woolimi/pinkrab/docs/src/content/docs/index.mdx

---
title: Pinkrab
description: 벽에 부착하는 6-DOF 양팔 로봇과 UMI 그리퍼 Hermit.
template: splash
---

import Landing from '../../components/Landing.astro';

<Landing />
