woolimi/pinkrab/docs/src/content/docs/en/index.mdx

---
title: Pinkrab
description: A wall-mounted 6-DOF bimanual robot and Hermit, a UMI gripper.
template: splash
---

import Landing from '../../../components/Landing.astro';

<Landing />
