woolimi/pinkrab/src/pinkrab_description/meshes/base_right.stl

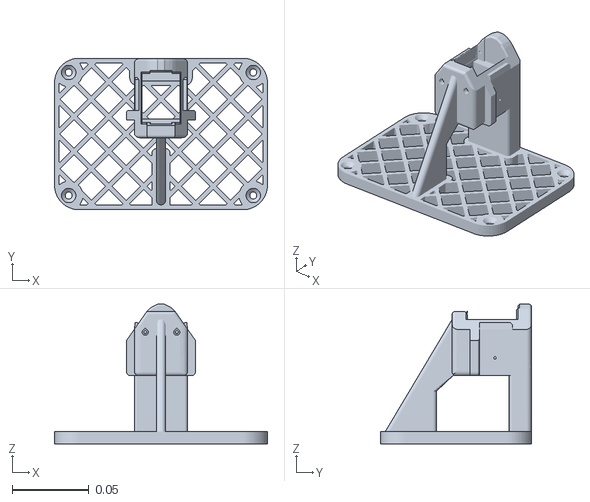
[picture p11: CAD file, 2026-11-01]
src/pinkrab_description/meshes/base_right.stl
0.139 x 0.0985 x 0.0908
