woolimi/pinkrab/src/pinkrab_description/mjcf/collision/camera_bracket_right_c05.stl

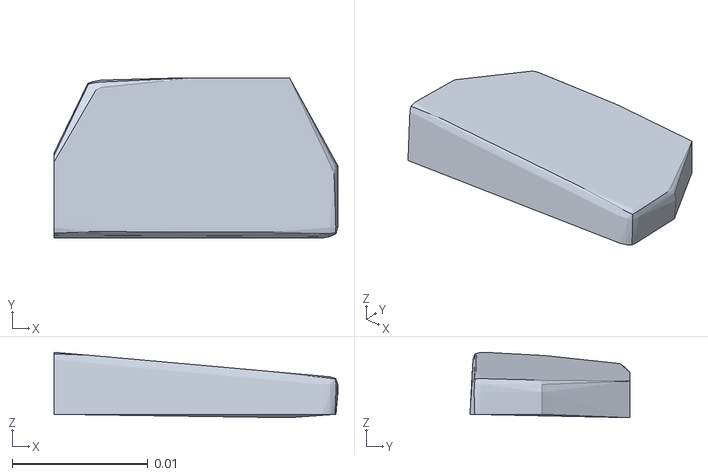
[picture p12: CAD file, 2026-11-01]
src/pinkrab_description/mjcf/collision/camera_bracket_right_c05.stl
0.0209 x 0.0118 x 0.00482
