woolimi/pinkrab/src/pinkrab_description/print/shoulder_right.stl

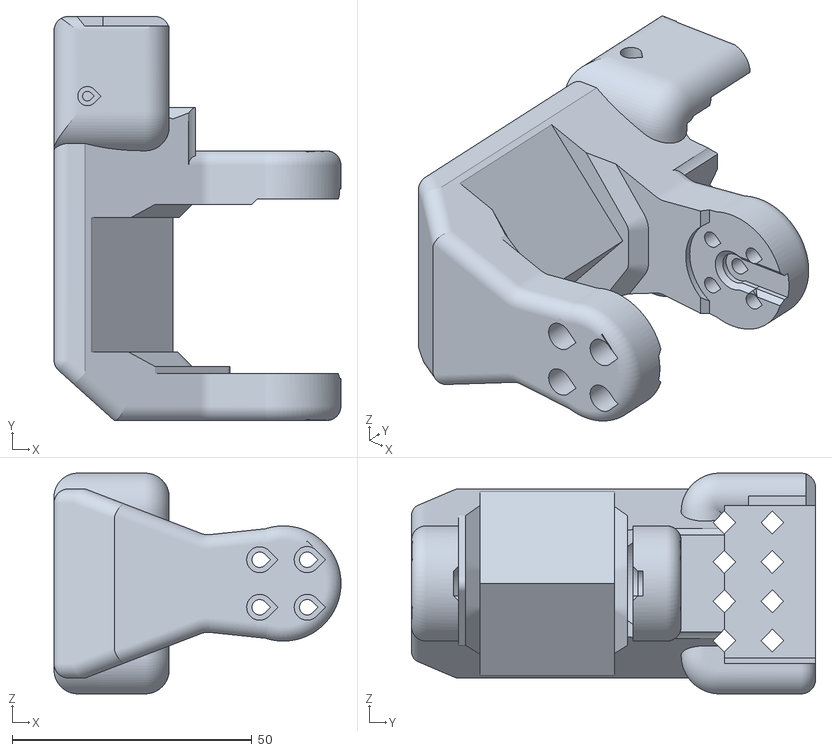
[picture p13: CAD file, 2026-11-01]
src/pinkrab_description/print/shoulder_right.stl
59.8 x 84.2 x 46.0
