woolimi/pinkrab/src/pinkrab_umi/meshes/handheld_peg_right.stl

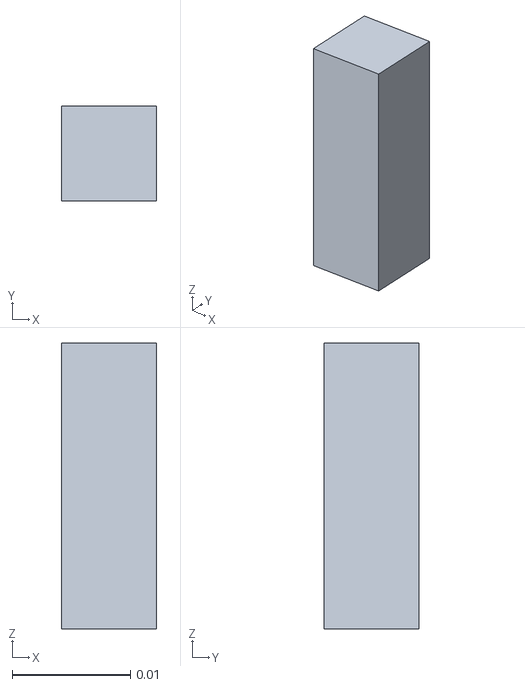
[picture p14: CAD file, 2026-11-01]
src/pinkrab_umi/meshes/handheld_peg_right.stl
0.008 x 0.008 x 0.0242
