woolimi/pinkrab/src/pinkrab_umi/print/marker_solid_tiles_desk.stl

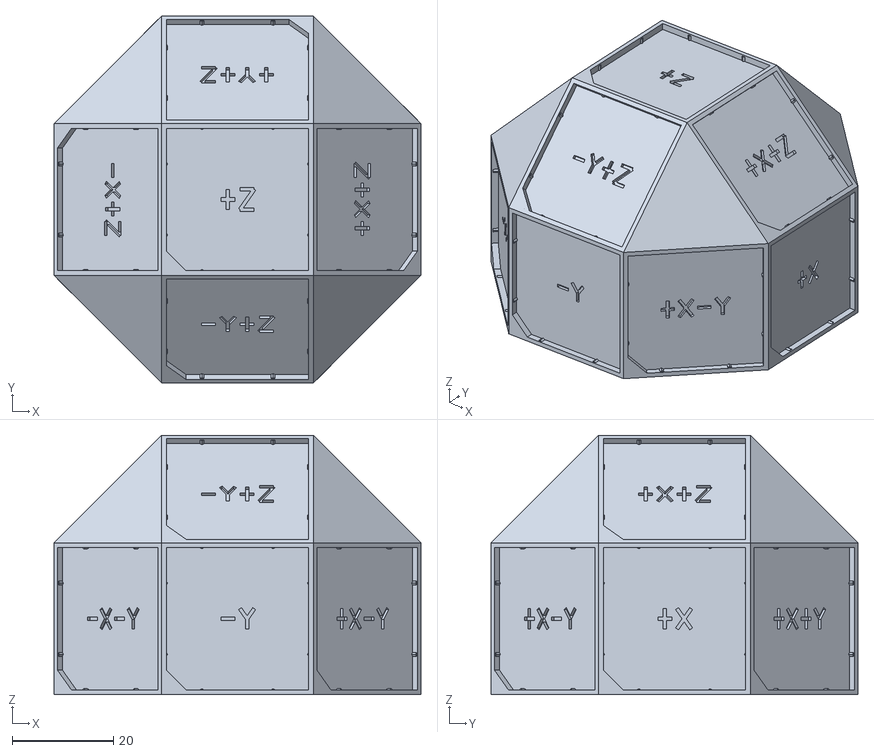
[picture p15: CAD file, 2026-11-01]
src/pinkrab_umi/print/marker_solid_tiles_desk.stl
72.4 x 72.4 x 51.2
