woolimi/pinkrab/src/pinkrab_description/meshes/wrist_left.stl

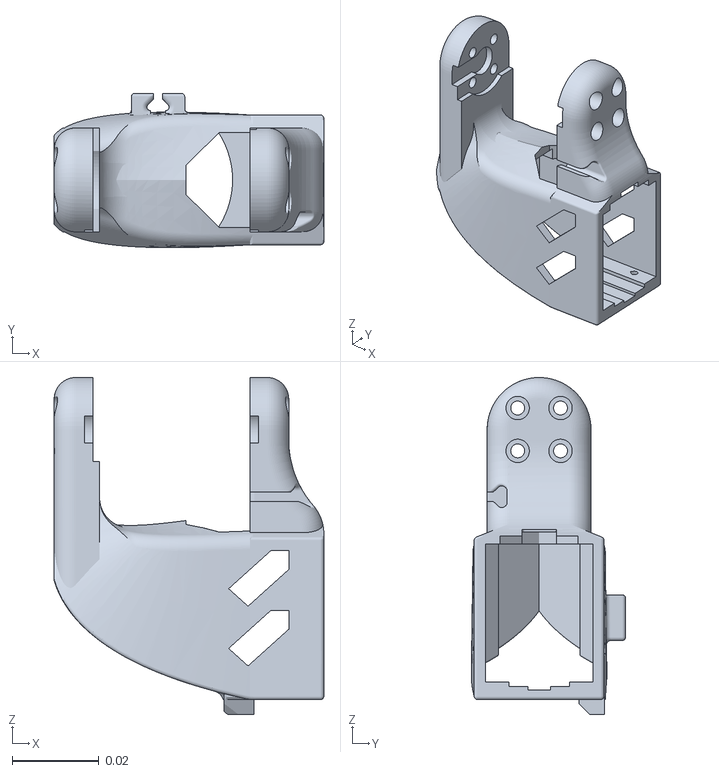
[picture p16: CAD file, 2026-11-01]
src/pinkrab_description/meshes/wrist_left.stl
0.0623 x 0.0357 x 0.0778
