woolimi/pinkrab/src/pinkrab_description/mjcf/collision/jaw_right_c05.stl

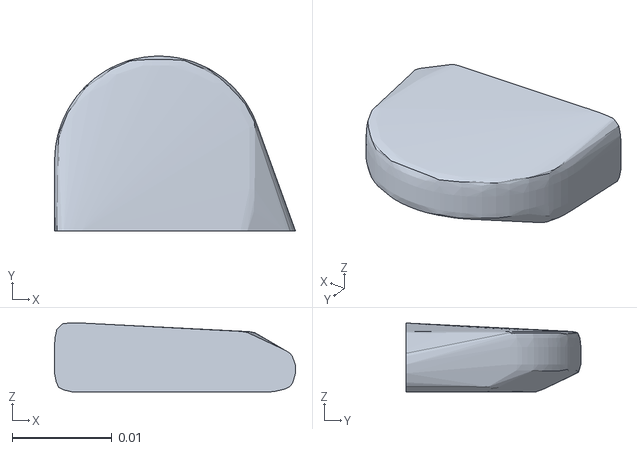
[picture p17: CAD file, 2026-11-01]
src/pinkrab_description/mjcf/collision/jaw_right_c05.stl
0.0242 x 0.0175 x 0.00692
