woolimi/pinkrab/src/pinkrab_description/print/driver_mount_left.stl

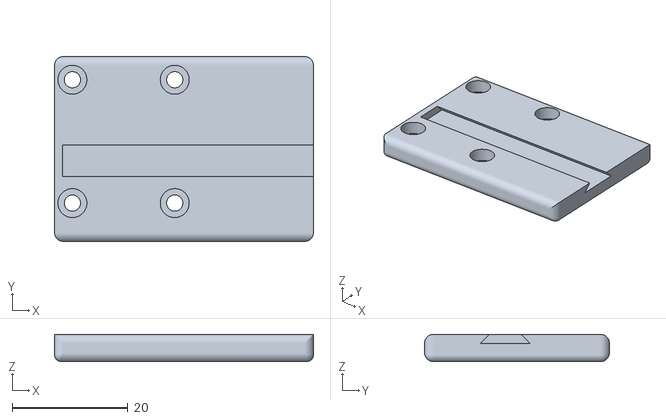
[picture p18: CAD file, 2026-11-01]
src/pinkrab_description/print/driver_mount_left.stl
44.7 x 31.9 x 4.68
