woolimi/pinkrab/src/pinkrab_umi/meshes/camera_bracket_right.stl

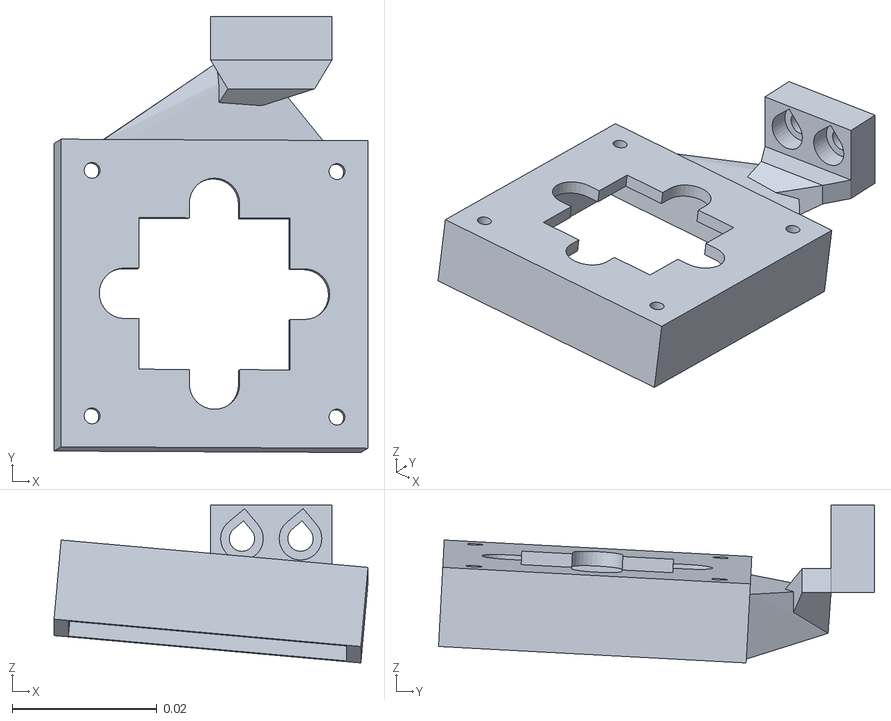
[picture p19: CAD file, 2026-11-01]
src/pinkrab_umi/meshes/camera_bracket_right.stl
0.0434 x 0.0603 x 0.0218
