woolimi/pinkrab/src/pinkrab_umi/print/camera_bracket_left.stl

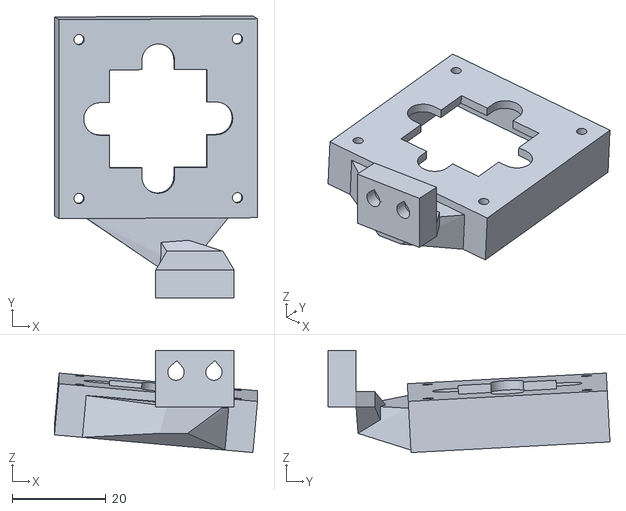
[picture p20: CAD file, 2026-11-01]
src/pinkrab_umi/print/camera_bracket_left.stl
43.4 x 60.3 x 21.8
