woolimi/pinkrab/src/pinkrab_description/mjcf/collision/claw_right_c08.stl

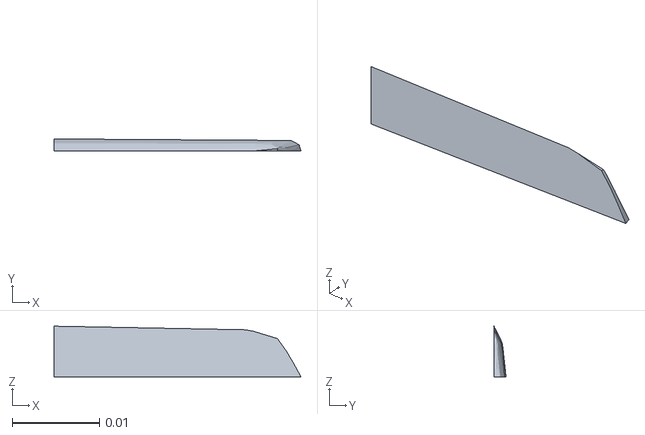
[picture p21: CAD file, 2026-11-01]
src/pinkrab_description/mjcf/collision/claw_right_c08.stl
0.0284 x 0.0014 x 0.00582
