woolimi/pinkrab/src/pinkrab_umi/meshes/board_mount_right.stl

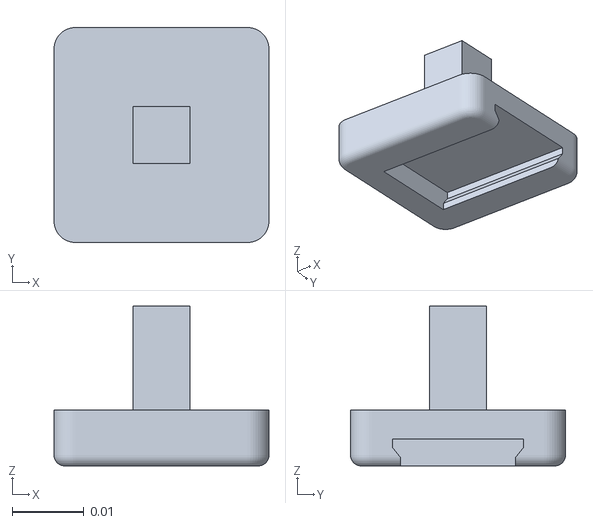
[picture p22: CAD file, 2026-11-01]
src/pinkrab_umi/meshes/board_mount_right.stl
0.03 x 0.03 x 0.0223
