woolimi/pinkrab/src/pinkrab_umi/print/handheld_jaw_right.stl

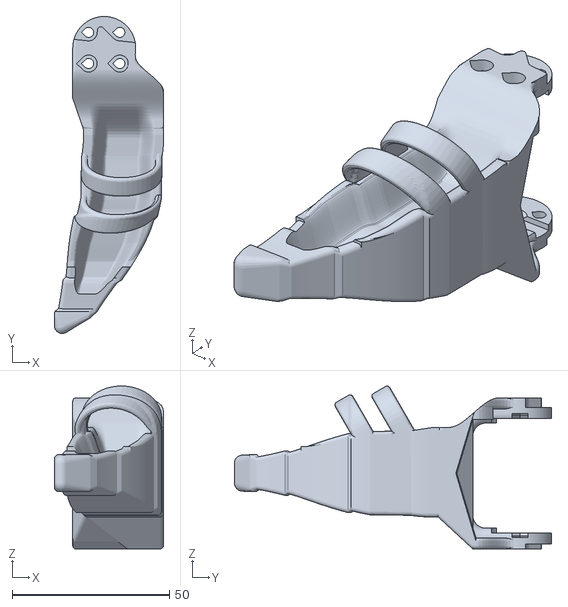
[picture p23: CAD file, 2026-11-01]
src/pinkrab_umi/print/handheld_jaw_right.stl
34.8 x 100.7 x 51.8
