woolimi/pinkrab/src/pinkrab_description/meshes/jaw_right.stl

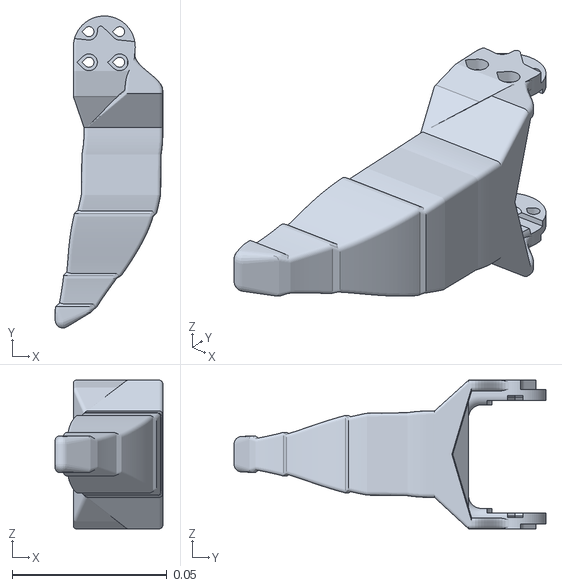
[picture p24: CAD file, 2026-11-01]
src/pinkrab_description/meshes/jaw_right.stl
0.0348 x 0.101 x 0.048
