woolimi/pinkrab/src/pinkrab_description/mjcf/collision/camera_bracket_right_c20.stl

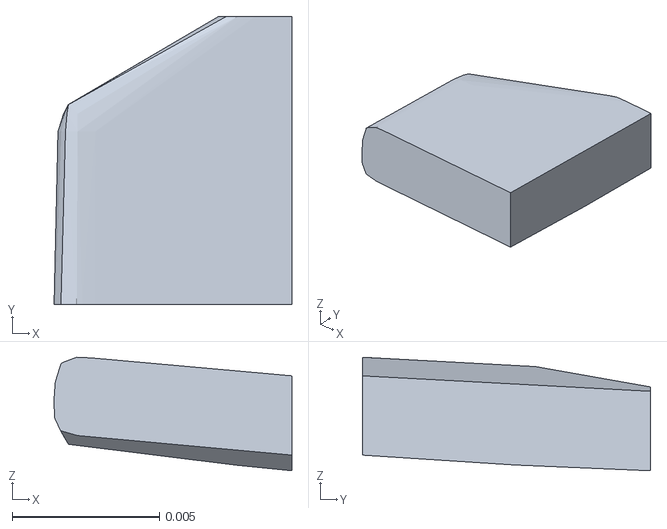
[picture p25: CAD file, 2026-11-01]
src/pinkrab_description/mjcf/collision/camera_bracket_right_c20.stl
0.00807 x 0.00977 x 0.00385
