woolimi/pinkrab/src/pinkrab_umi/meshes/marker_solid_handheld_left.stl

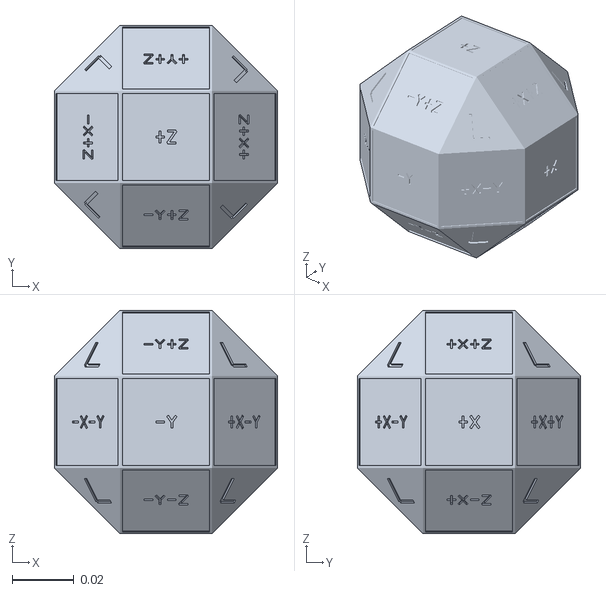
[picture p26: CAD file, 2026-11-01]
src/pinkrab_umi/meshes/marker_solid_handheld_left.stl
0.0724 x 0.0724 x 0.0724
