woolimi/pinkrab/src/pinkrab_description/mjcf/collision/claw_left_c04.stl

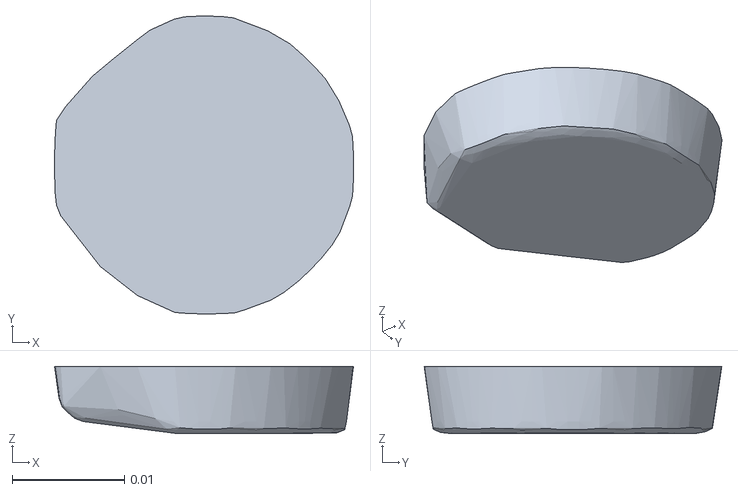
[picture p27: CAD file, 2026-11-01]
src/pinkrab_description/mjcf/collision/claw_left_c04.stl
0.0267 x 0.0266 x 0.00602
