woolimi/pinkrab/src/pinkrab_description/print/base_servo_mount_left.stl

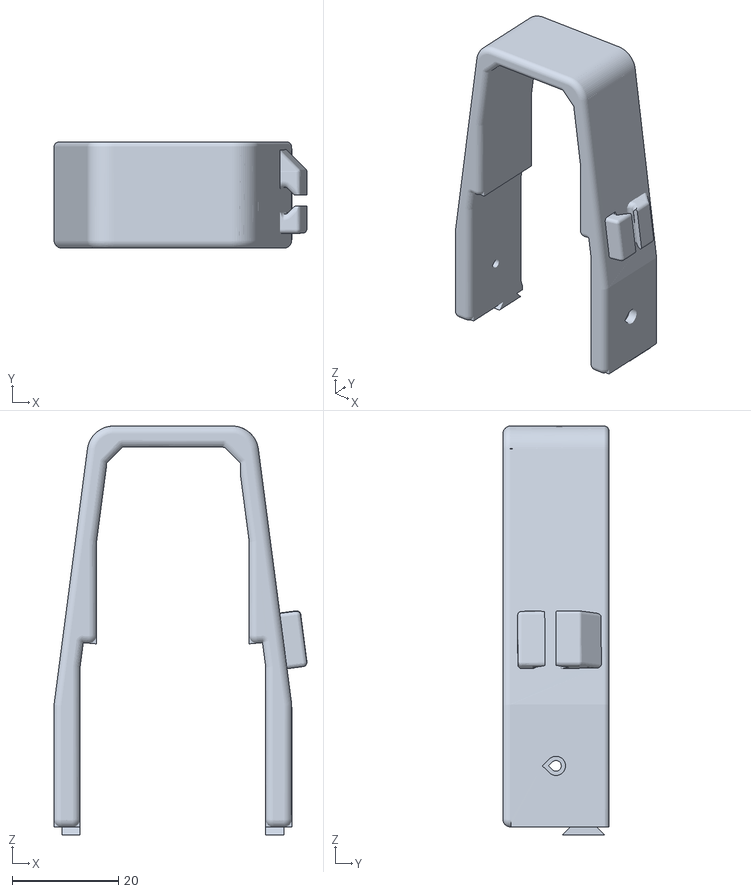
[picture p28: CAD file, 2026-11-01]
src/pinkrab_description/print/base_servo_mount_left.stl
47.6 x 20.0 x 76.9
