woolimi/pinkrab/src/pinkrab_umi/meshes/handheld_body_right.stl

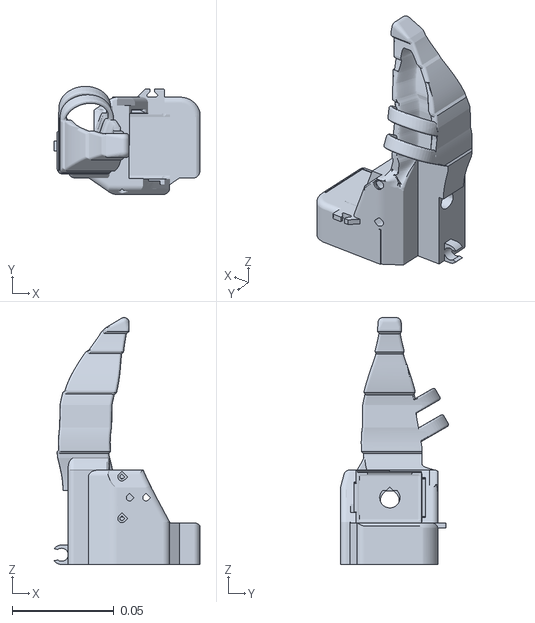
[picture p29: CAD file, 2026-11-01]
src/pinkrab_umi/meshes/handheld_body_right.stl
0.0718 x 0.0533 x 0.122
