woolimi/pinkrab/src/pinkrab_umi/print/driver_plate_left.stl

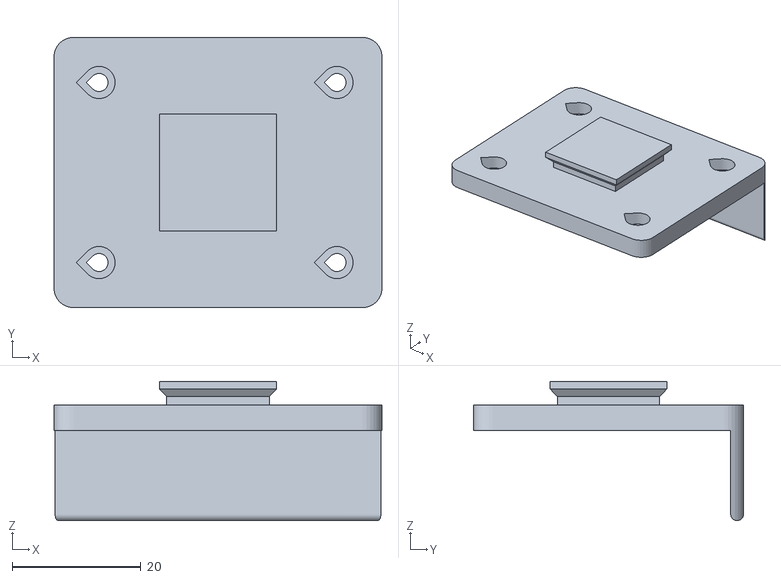
[picture p30: CAD file, 2026-11-01]
src/pinkrab_umi/print/driver_plate_left.stl
51.0 x 42.0 x 21.6
