woolimi/pinkrab/src/pinkrab_description/meshes/upper_arm_right.stl

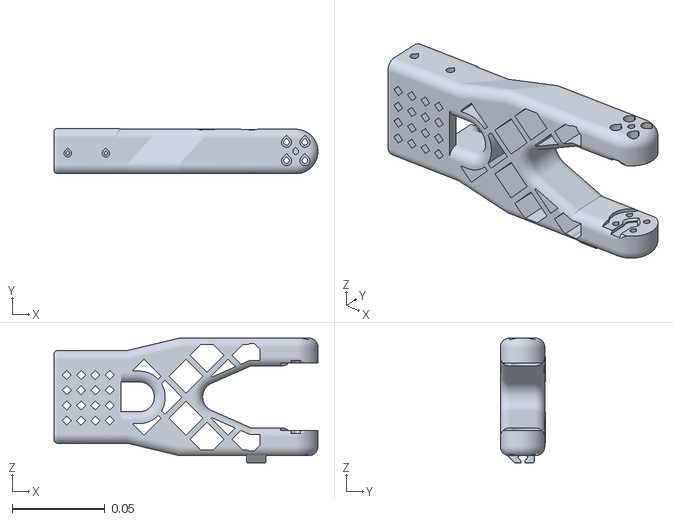
[picture p31: CAD file, 2026-11-01]
src/pinkrab_description/meshes/upper_arm_right.stl
0.142 x 0.0245 x 0.0673
