woolimi/pinkrab/src/pinkrab_description/mjcf/collision/camera_bracket_right_c18.stl

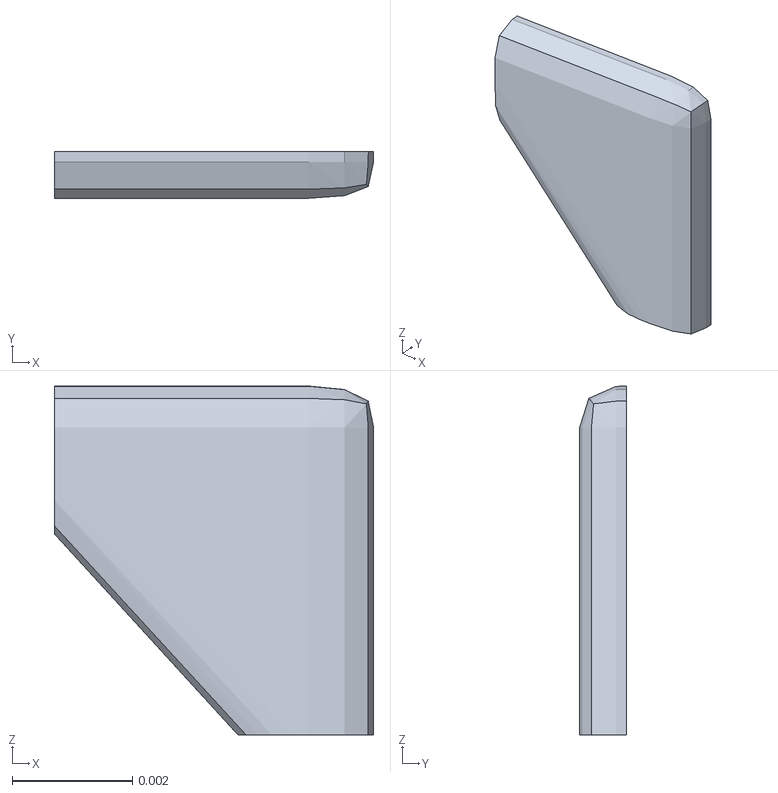
[picture p32: CAD file, 2026-11-01]
src/pinkrab_description/mjcf/collision/camera_bracket_right_c18.stl
0.0053 x 0.000774 x 0.0058
