woolimi/pinkrab/src/pinkrab_umi/meshes/driver_plate_left.stl

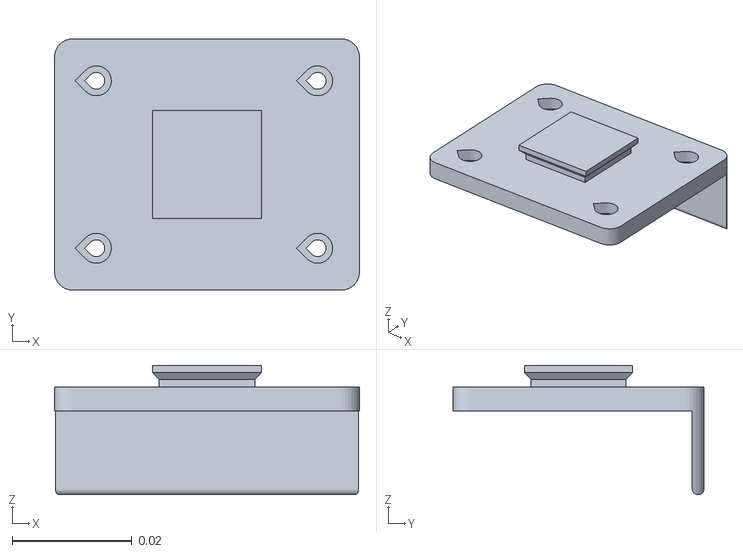
[picture p33: CAD file, 2026-11-01]
src/pinkrab_umi/meshes/driver_plate_left.stl
0.051 x 0.042 x 0.0216
