woolimi/pinkrab/src/pinkrab_description/mjcf/collision/camera_bracket_left_c14.stl

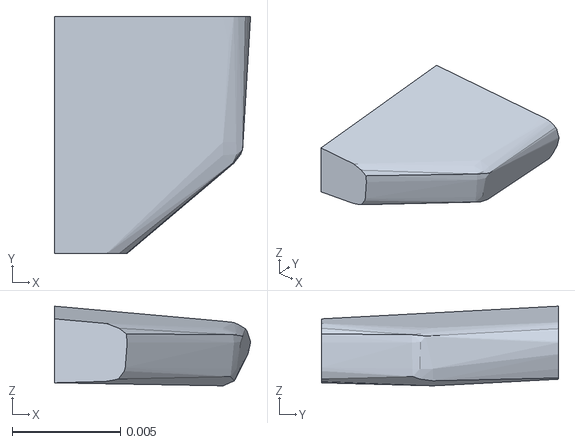
[picture p35: CAD file, 2026-11-01]
src/pinkrab_description/mjcf/collision/camera_bracket_left_c14.stl
0.00906 x 0.0109 x 0.00368
