woolimi/pinkrab/src/pinkrab_description/print/shoulder_servo_mount_right.stl

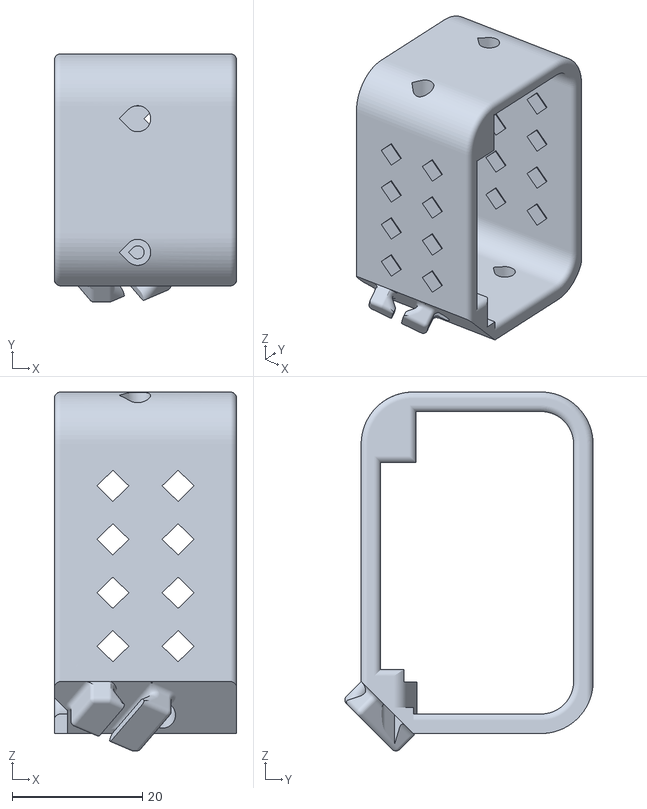
[picture p36: CAD file, 2026-11-01]
src/pinkrab_description/print/shoulder_servo_mount_right.stl
28.0 x 38.1 x 55.1
