woolimi/pinkrab/src/pinkrab_umi/print/board_mount_right.stl

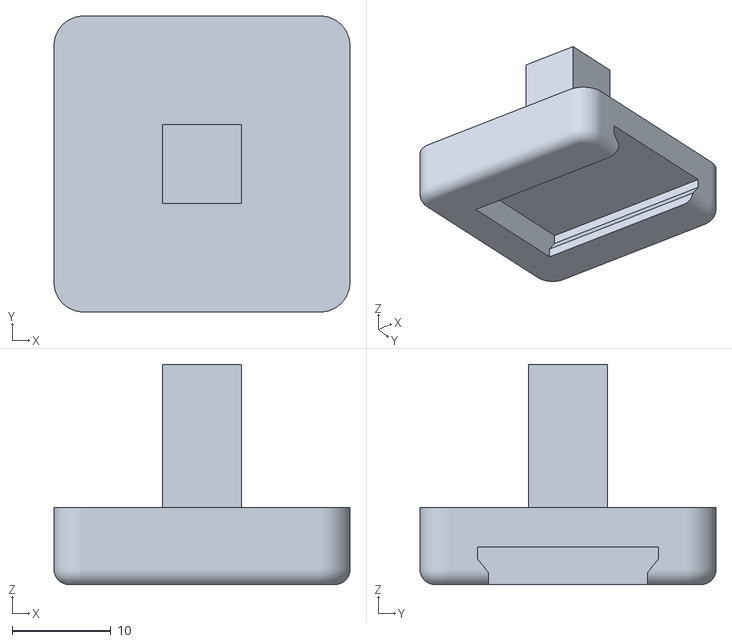
[picture p37: CAD file, 2026-11-01]
src/pinkrab_umi/print/board_mount_right.stl
30.0 x 30.0 x 22.3
