woolimi/pinkrab/src/pinkrab_description/mjcf/collision/camera_bracket_left_c17.stl

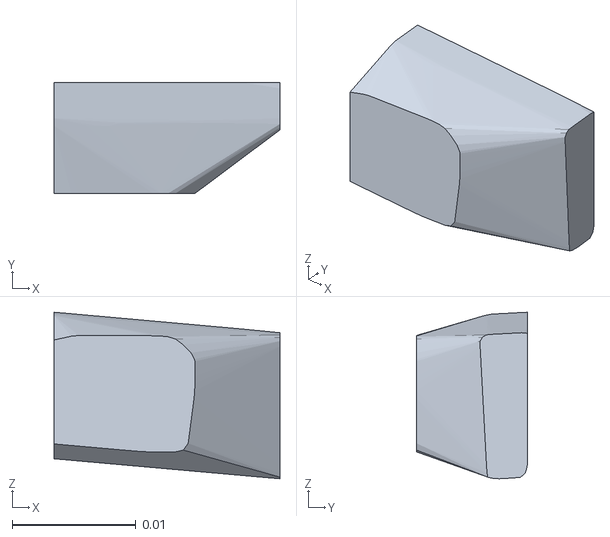
[picture p38: CAD file, 2026-11-01]
src/pinkrab_description/mjcf/collision/camera_bracket_left_c17.stl
0.0183 x 0.00897 x 0.0135
