woolimi/pinkrab/src/pinkrab_description/print/driver_mount_right.stl

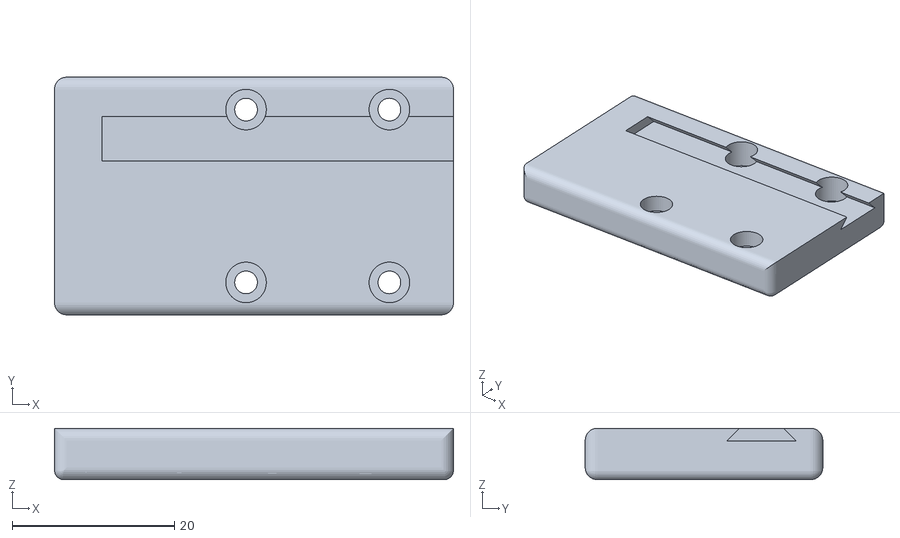
[picture p39: CAD file, 2026-11-01]
src/pinkrab_description/print/driver_mount_right.stl
49.2 x 29.3 x 6.33
