woolimi/pinkrab/src/pinkrab_umi/meshes/handheld_jaw_right.stl

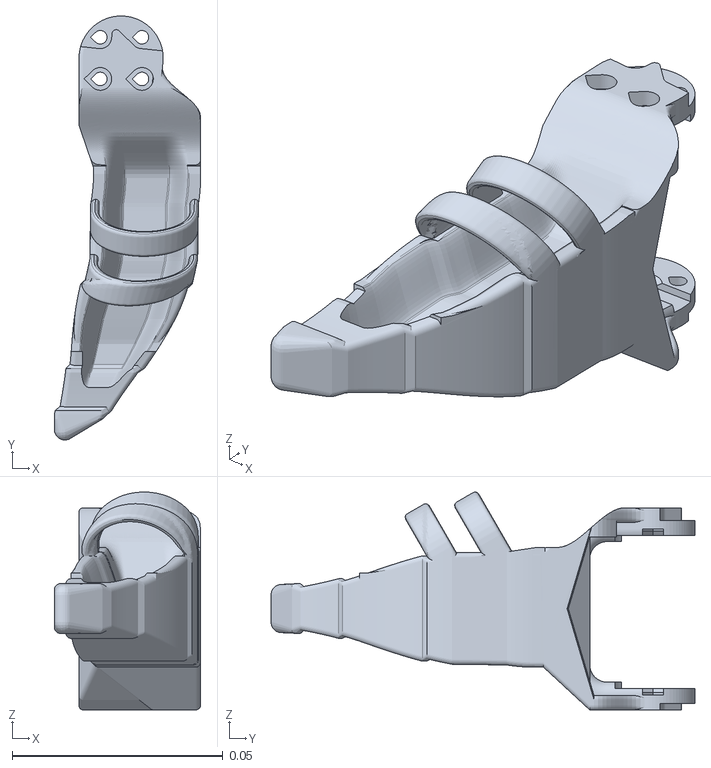
[picture p40: CAD file, 2026-11-01]
src/pinkrab_umi/meshes/handheld_jaw_right.stl
0.0348 x 0.101 x 0.0518
