woolimi/pinkrab/src/pinkrab_umi/print/marker_solid_handheld_left.stl

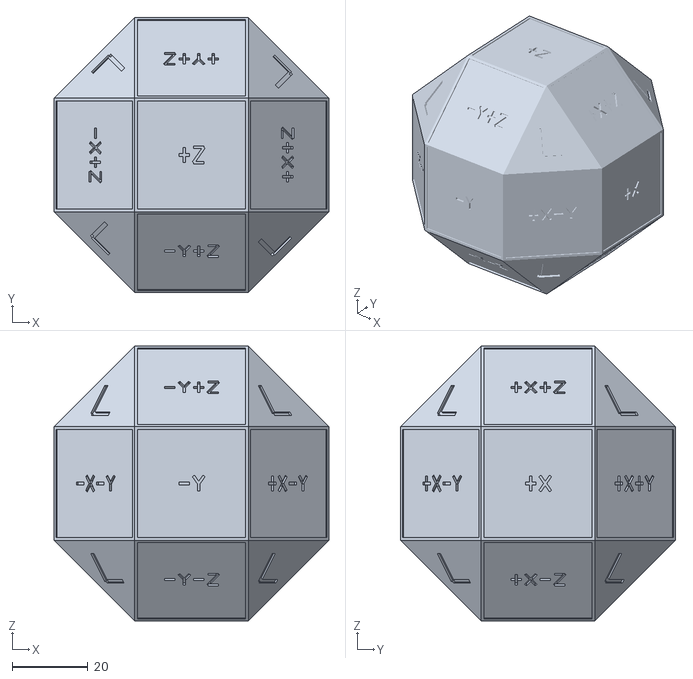
[picture p41: CAD file, 2026-11-01]
src/pinkrab_umi/print/marker_solid_handheld_left.stl
72.4 x 72.4 x 72.4
