woolimi/pinkrab/src/pinkrab_description/meshes/driver_mount_right.stl

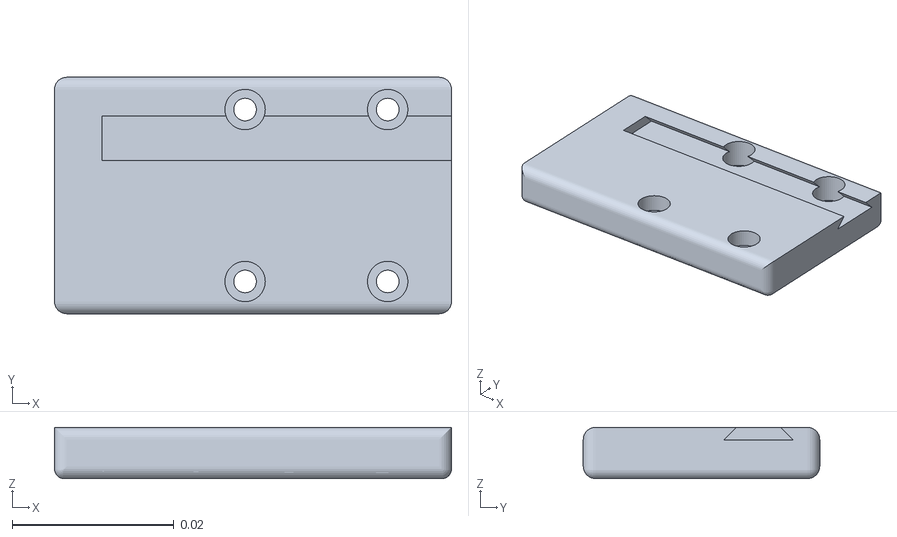
[picture p42: CAD file, 2026-11-01]
src/pinkrab_description/meshes/driver_mount_right.stl
0.0492 x 0.0293 x 0.00633
