woolimi/pinkrab/src/pinkrab_description/mjcf/collision/camera_bracket_right_c00.stl

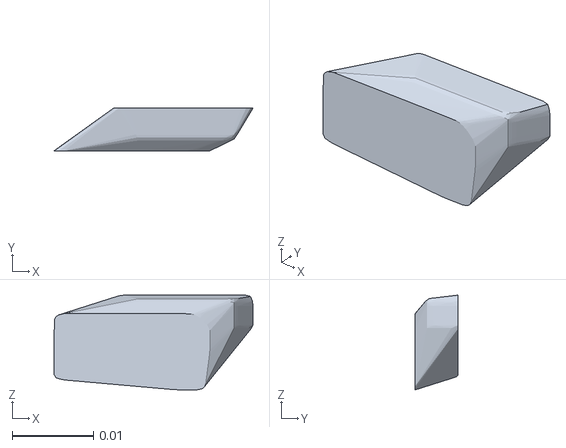
[picture p43: CAD file, 2026-11-01]
src/pinkrab_description/mjcf/collision/camera_bracket_right_c00.stl
0.0245 x 0.00524 x 0.0117
