woolimi/pinkrab/src/pinkrab_umi/print/umi_handheld_tiles.3mf

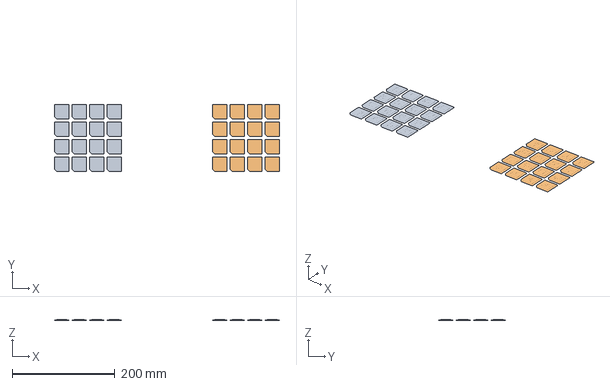
[picture p44: CAD file, 2026-11-01]
src/pinkrab_umi/print/umi_handheld_tiles.3mf
437.2 x 130.0 x 1.40 mm
marker_tiles_handheld_right
marker_tiles_handheld_left
