woolimi/pinkrab/src/pinkrab_description/meshes/claw_left.stl

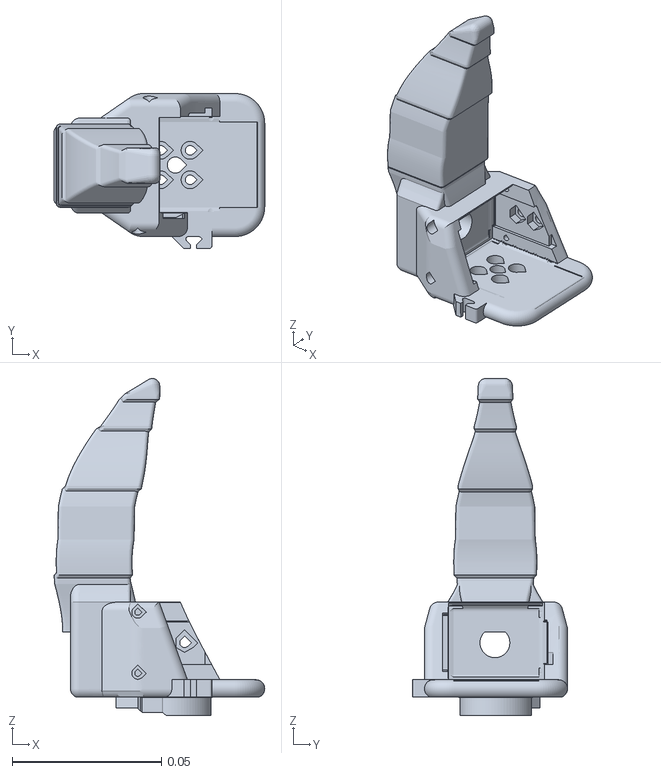
[picture p45: CAD file, 2026-11-01]
src/pinkrab_description/meshes/claw_left.stl
0.0706 x 0.052 x 0.113
