woolimi/pinkrab/src/pinkrab_description/mjcf/collision/camera_bracket_left_c10.stl

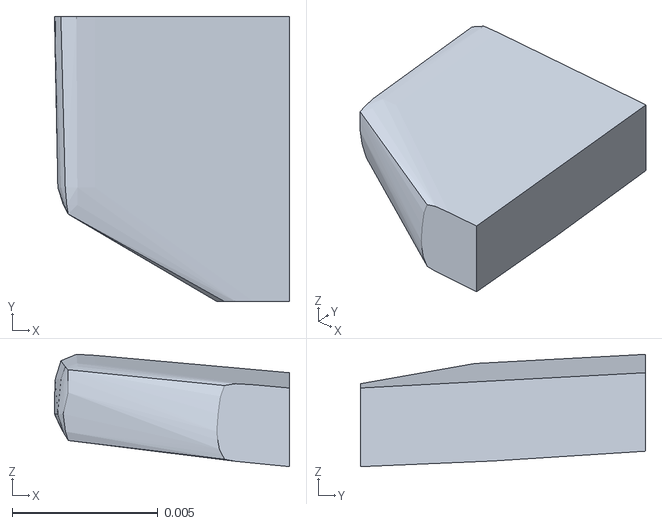
[picture p46: CAD file, 2026-11-01]
src/pinkrab_description/mjcf/collision/camera_bracket_left_c10.stl
0.00806 x 0.00976 x 0.00385
