woolimi/pinkrab/src/pinkrab_description/print/base_right.stl

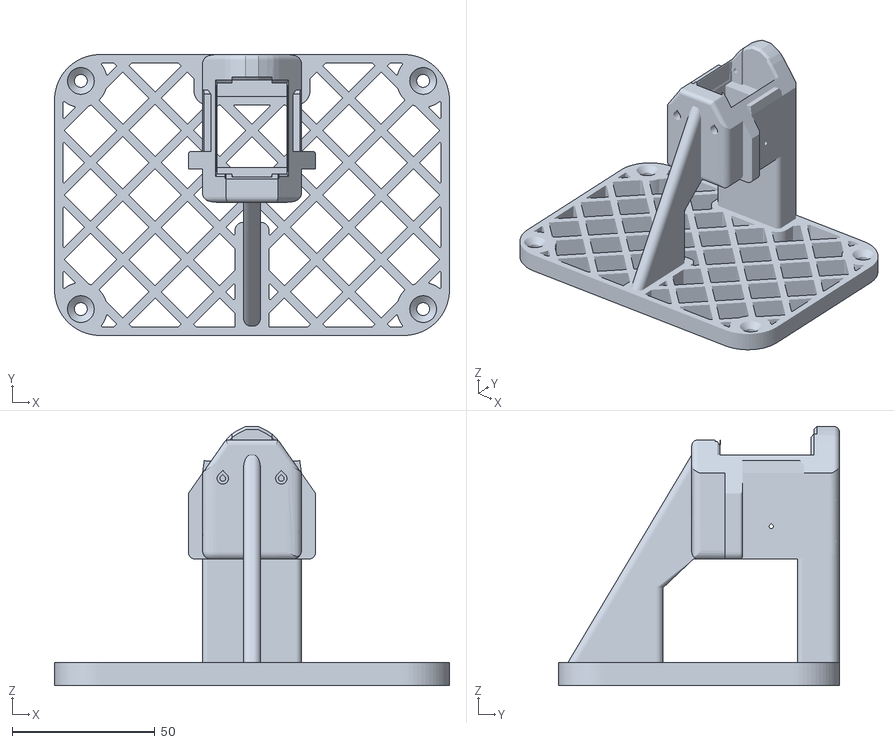
[picture p47: CAD file, 2026-11-01]
src/pinkrab_description/print/base_right.stl
138.5 x 98.5 x 90.8
