woolimi/pinkrab/src/pinkrab_umi/print/handheld_peg_left.stl

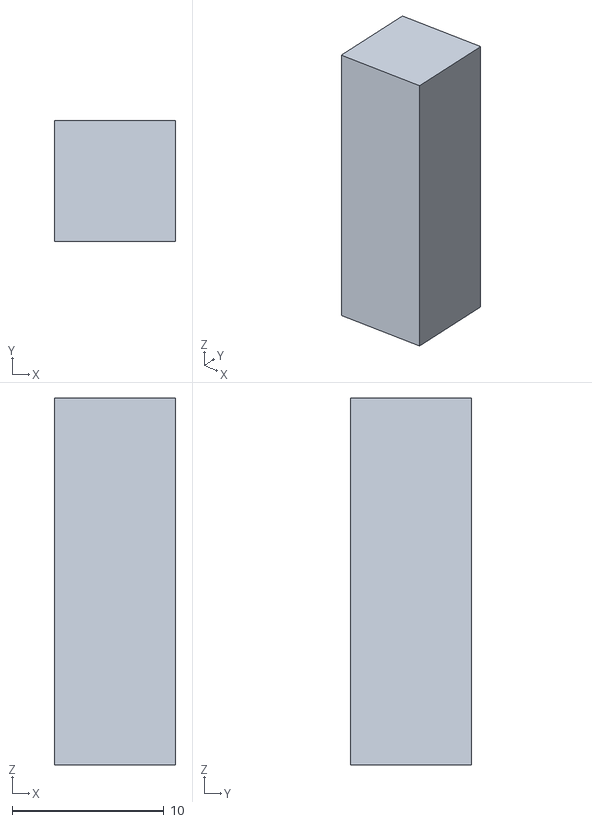
[picture p48: CAD file, 2026-11-01]
src/pinkrab_umi/print/handheld_peg_left.stl
8.00 x 8.00 x 24.2
