woolimi/pinkrab/src/pinkrab_description/meshes/base_servo_mount_right.stl

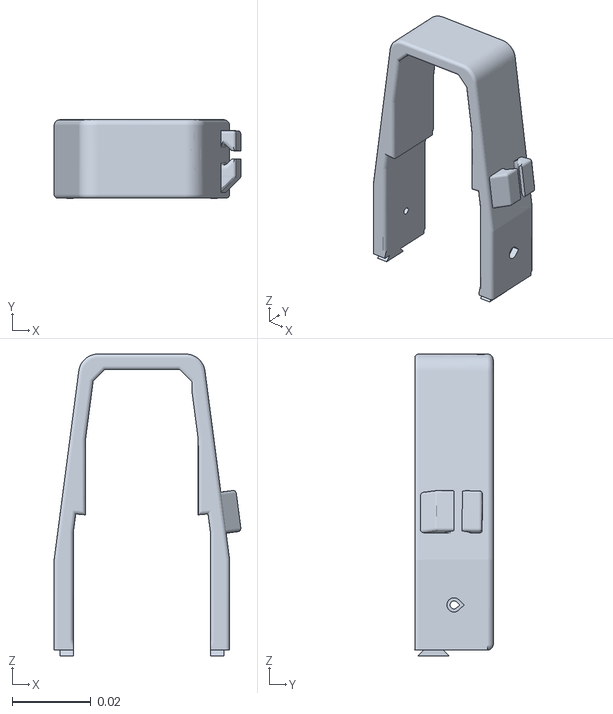
[picture p49: CAD file, 2026-11-01]
src/pinkrab_description/meshes/base_servo_mount_right.stl
0.0476 x 0.02 x 0.0769
