woolimi/pinkrab/src/pinkrab_description/mjcf/collision/claw_right_c00.stl

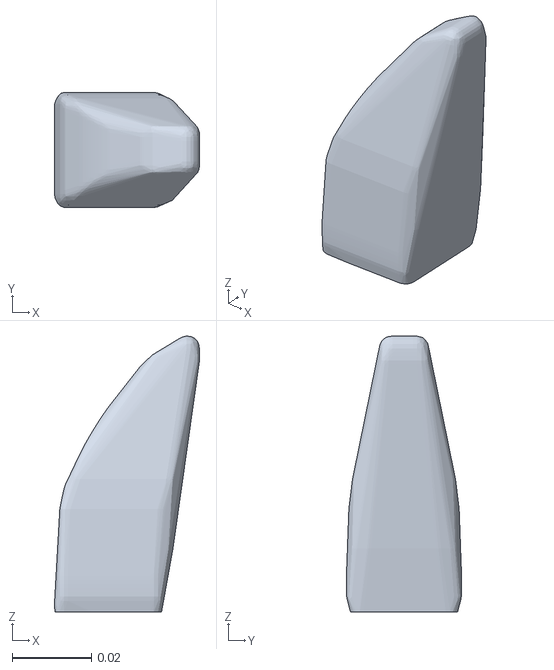
[picture p50: CAD file, 2026-11-01]
src/pinkrab_description/mjcf/collision/claw_right_c00.stl
0.0365 x 0.029 x 0.0695
