woolimi/pinkrab/src/pinkrab_umi/print/handheld_body_right.stl

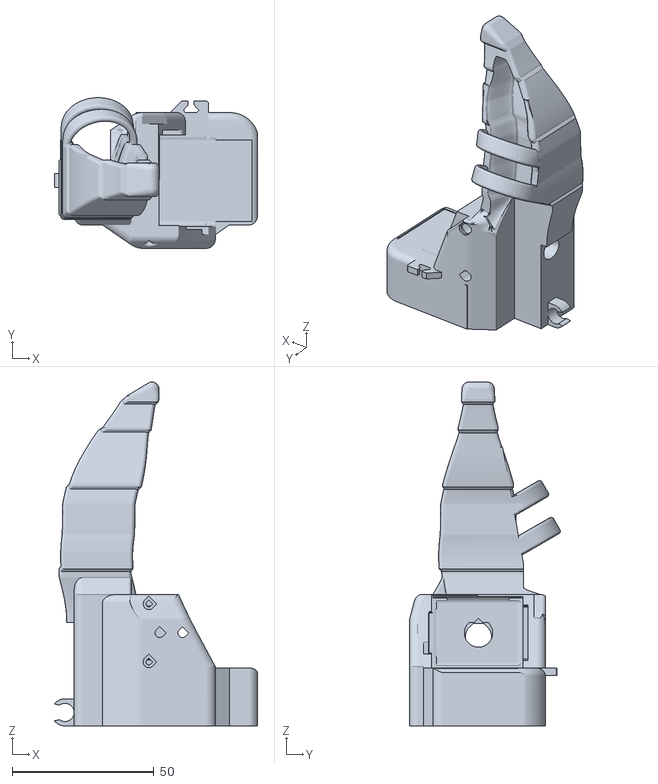
[picture p51: CAD file, 2026-11-01]
src/pinkrab_umi/print/handheld_body_right.stl
71.8 x 53.3 x 121.5
