woolimi/pinkrab/src/pinkrab_description/meshes/servo.stl

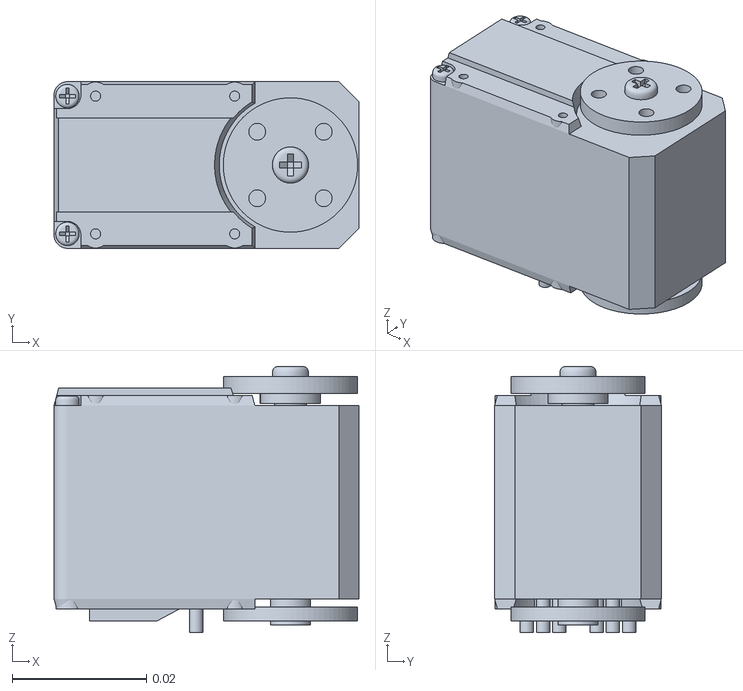
[picture p52: CAD file, 2026-11-01]
src/pinkrab_description/meshes/servo.stl
0.0454 x 0.0248 x 0.0396
