woolimi/pinkrab/src/pinkrab_description/mjcf/collision/jaw_right_c02.stl

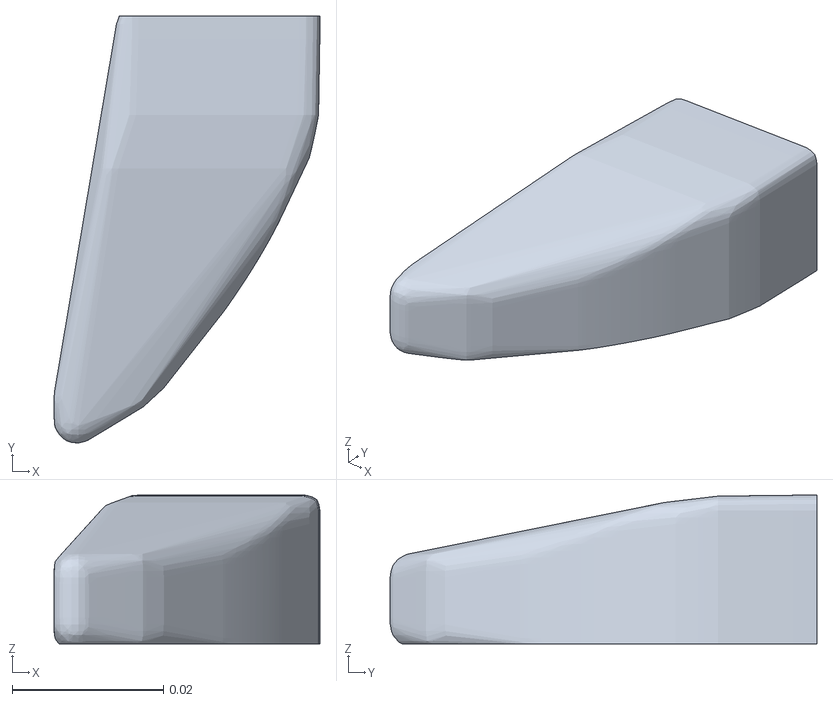
[picture p53: CAD file, 2026-11-01]
src/pinkrab_description/mjcf/collision/jaw_right_c02.stl
0.0352 x 0.0565 x 0.0197
