woolimi/pinkrab/src/pinkrab_description/print/wrist_left.stl

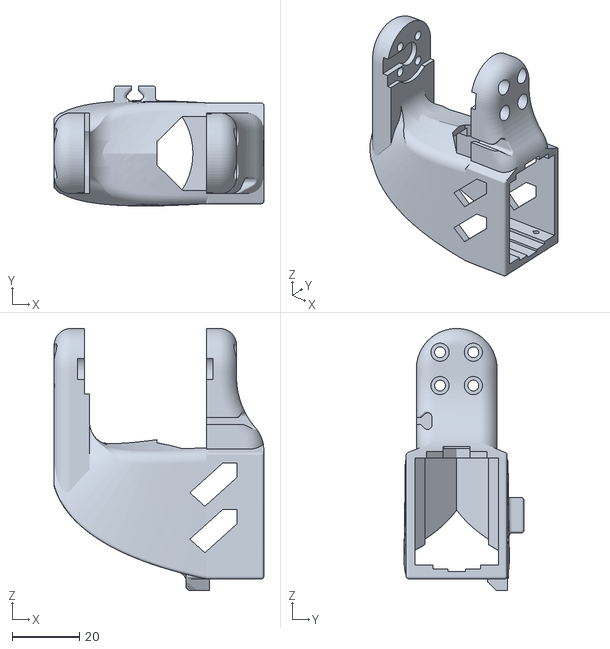
[picture p54: CAD file, 2026-11-01]
src/pinkrab_description/print/wrist_left.stl
62.3 x 35.7 x 77.8
