woolimi/pinkrab/src/pinkrab_description/mjcf/collision/jaw_left_c04.stl

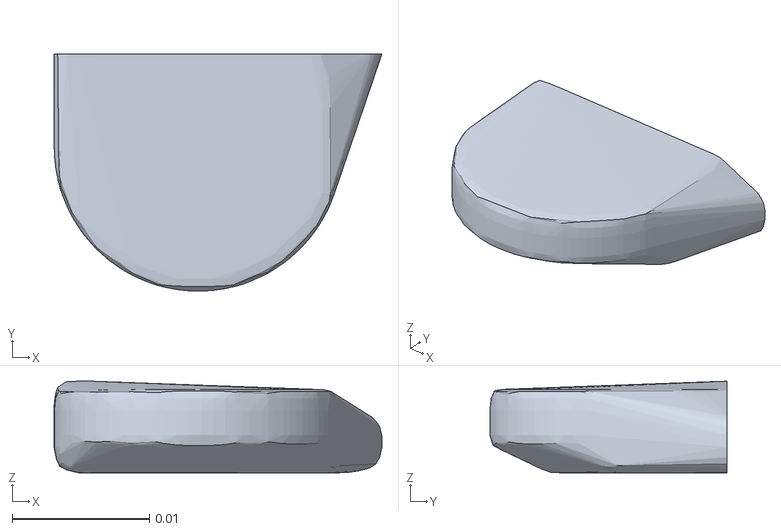
[picture p55: CAD file, 2026-11-01]
src/pinkrab_description/mjcf/collision/jaw_left_c04.stl
0.0239 x 0.0173 x 0.00667
