woolimi/pinkrab/src/pinkrab_description/print/claw_left.stl

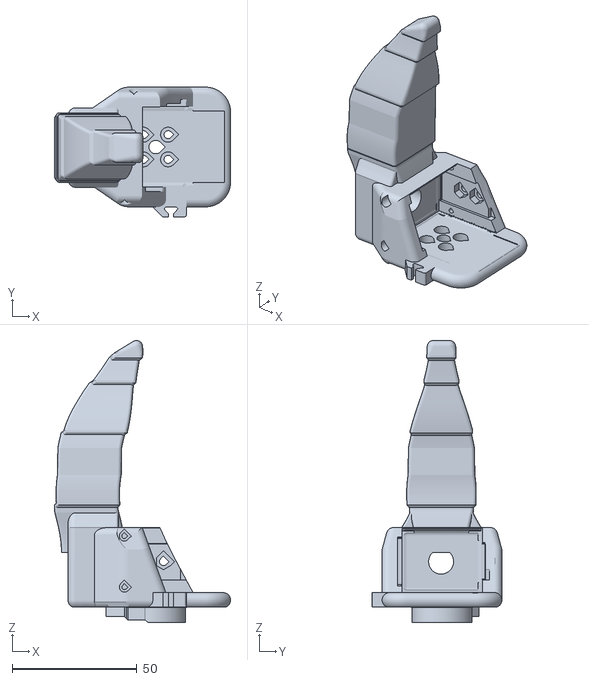
[picture p56: CAD file, 2026-11-01]
src/pinkrab_description/print/claw_left.stl
70.6 x 52.0 x 113.1
