woolimi/pinkrab/src/pinkrab_umi/print/marker_tiles_handheld_white_right.stl

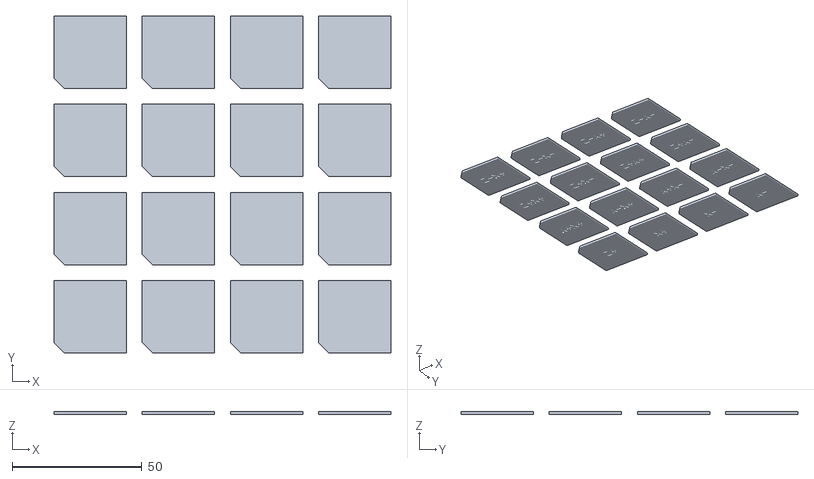
[picture p57: CAD file, 2026-11-01]
src/pinkrab_umi/print/marker_tiles_handheld_white_right.stl
130.0 x 130.0 x 1.00
