woolimi/pinkrab/src/pinkrab_description/meshes/shoulder_servo_mount_left.stl

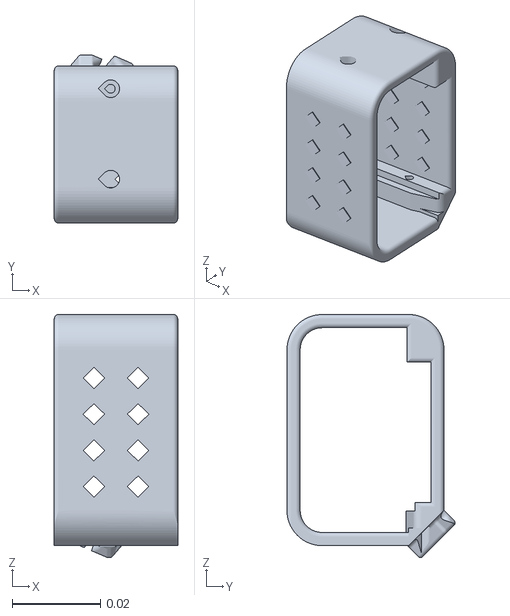
[picture p58: CAD file, 2026-11-01]
src/pinkrab_description/meshes/shoulder_servo_mount_left.stl
0.028 x 0.0381 x 0.0551
