woolimi/pinkrab/src/pinkrab_description/mjcf/collision/jaw_right_c01.stl

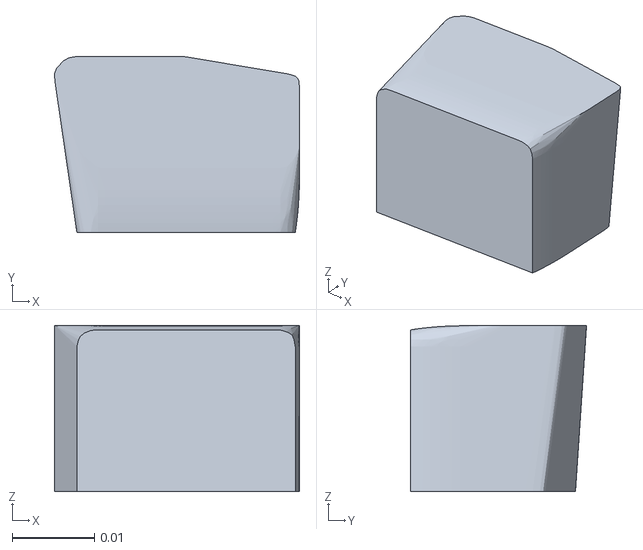
[picture p59: CAD file, 2026-11-01]
src/pinkrab_description/mjcf/collision/jaw_right_c01.stl
0.0298 x 0.0214 x 0.0202
