woolimi/pinkrab/src/pinkrab_description/print/jaw_left.stl

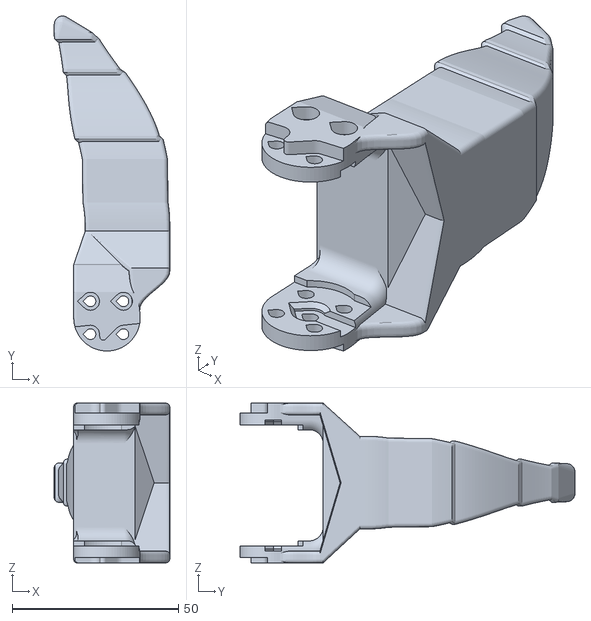
[picture p60: CAD file, 2026-11-01]
src/pinkrab_description/print/jaw_left.stl
34.8 x 100.7 x 48.0
