woolimi/pinkrab/src/pinkrab_description/meshes/wrist_yaw_bracket_left.stl

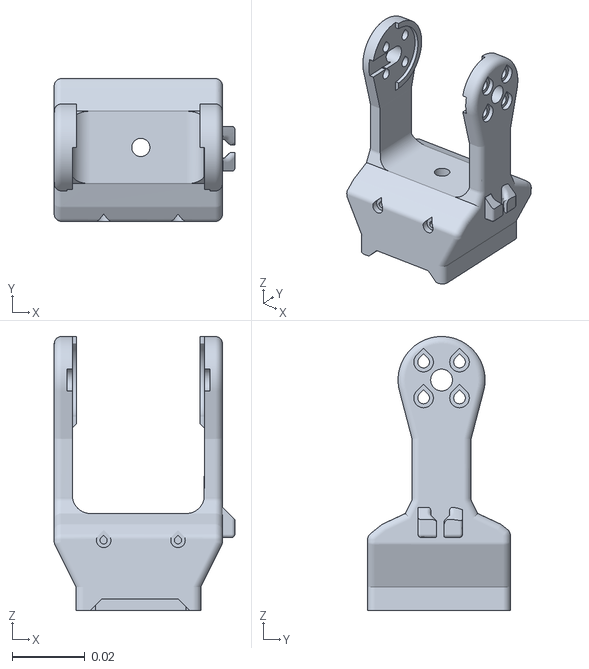
[picture p62: CAD file, 2026-11-01]
src/pinkrab_description/meshes/wrist_yaw_bracket_left.stl
0.0498 x 0.0394 x 0.0756
