woolimi/pinkrab/src/pinkrab_description/mjcf/collision/camera_bracket_left_c08.stl

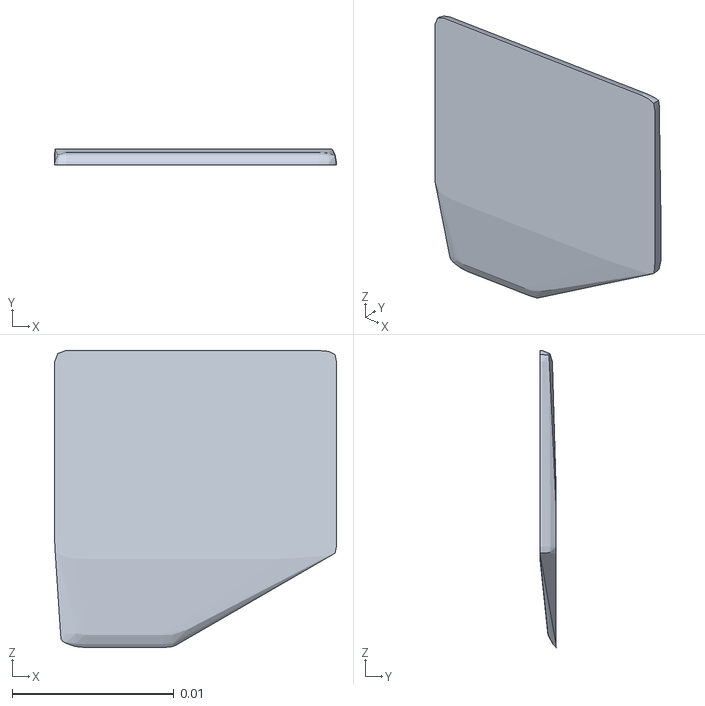
[picture p63: CAD file, 2026-11-01]
src/pinkrab_description/mjcf/collision/camera_bracket_left_c08.stl
0.0175 x 0.001 x 0.0184
