woolimi/pinkrab/src/pinkrab_umi/print/umi_handheld_parts_left.3mf

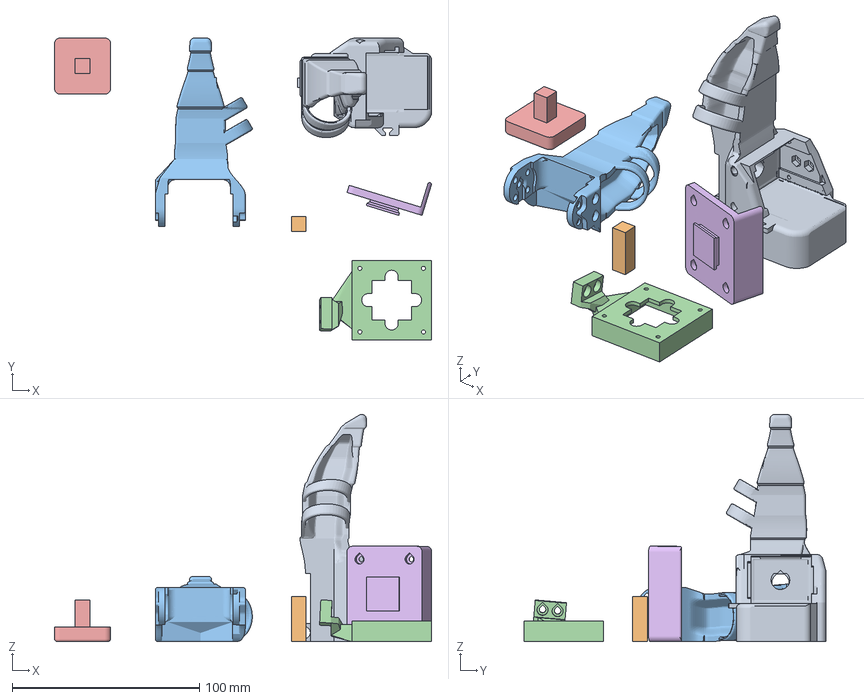
[picture p64: CAD file, 2026-11-01]
src/pinkrab_umi/print/umi_handheld_parts_left.3mf
201.5 x 161.4 x 121.5 mm
handheld_body_left_1
handheld_peg_left_1
handheld_jaw_left_1
camera_bracket_left_1
board_mount_left_1
driver_plate_left_1
