woolimi/pinkrab/src/pinkrab_description/mjcf/collision/camera_bracket_left_c07.stl

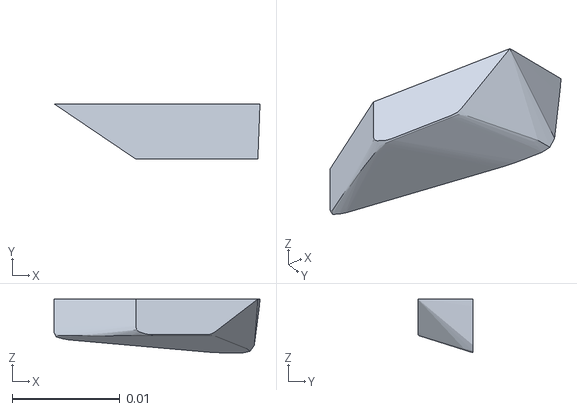
[picture p65: CAD file, 2026-11-01]
src/pinkrab_description/mjcf/collision/camera_bracket_left_c07.stl
0.0191 x 0.00515 x 0.00499
