woolimi/pinkrab/src/pinkrab_description/print/wrist_yaw_bracket_left.stl

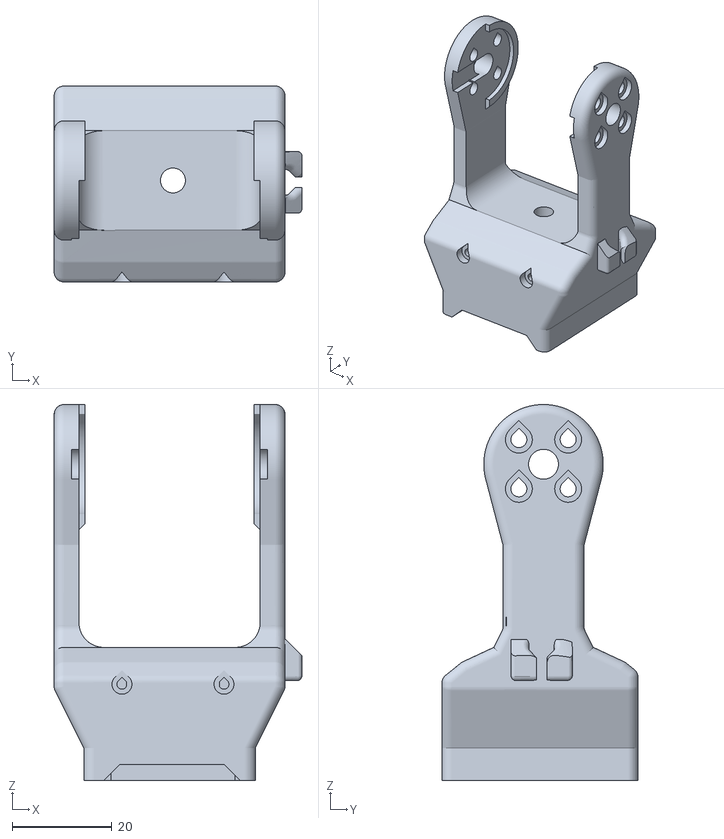
[picture p66: CAD file, 2026-11-01]
src/pinkrab_description/print/wrist_yaw_bracket_left.stl
49.8 x 39.4 x 75.6
