woolimi/pinkrab/src/pinkrab_umi/print/umi_handheld_solids.3mf

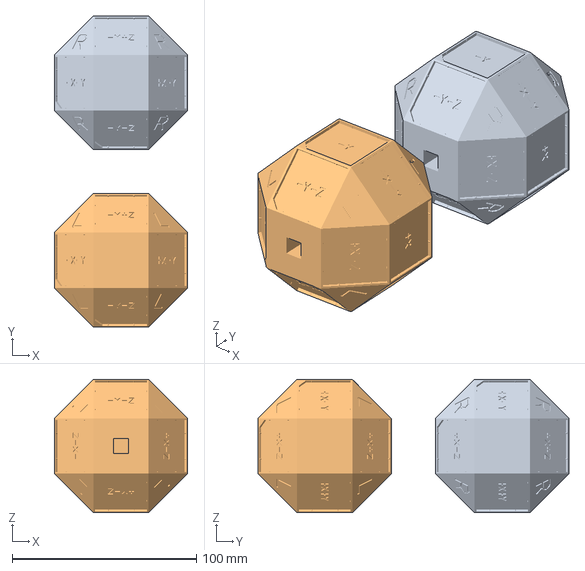
[picture p67: CAD file, 2026-11-01]
src/pinkrab_umi/print/umi_handheld_solids.3mf
72.4 x 168.9 x 72.4 mm
marker_cube_tiles_handheld_right_1
marker_cube_tiles_handheld_left_1
