woolimi/pinkrab/src/pinkrab_description/meshes/servo_no_horn.stl

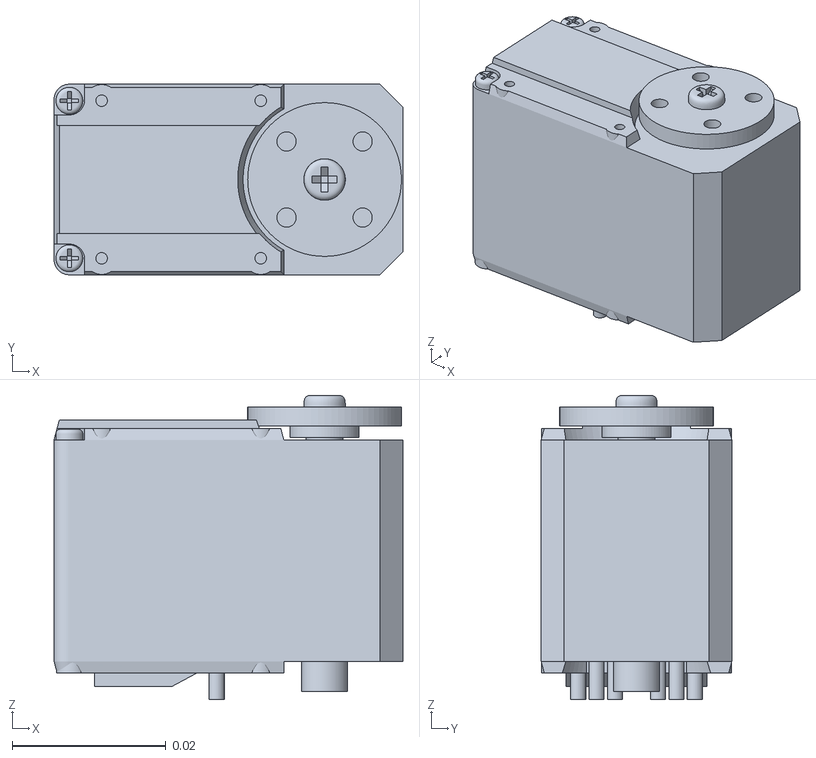
[picture p68: CAD file, 2026-11-01]
src/pinkrab_description/meshes/servo_no_horn.stl
0.0454 x 0.0248 x 0.0396
