woolimi/pinkrab/src/pinkrab_description/mjcf/collision/camera_bracket_left_c13.stl

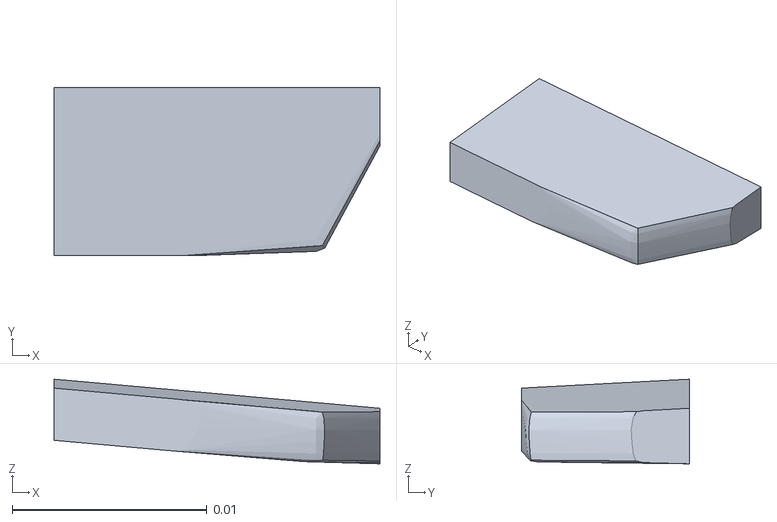
[picture p69: CAD file, 2026-11-01]
src/pinkrab_description/mjcf/collision/camera_bracket_left_c13.stl
0.0167 x 0.00862 x 0.00434
