woolimi/pinkrab/src/pinkrab_umi/print/umi_desk_tiles.3mf

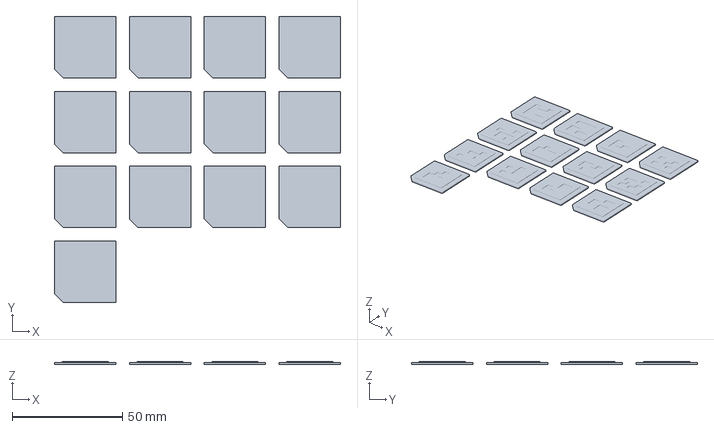
[picture p70: CAD file, 2026-11-01]
src/pinkrab_umi/print/umi_desk_tiles.3mf
130.0 x 130.0 x 1.40 mm
