woolimi/pinkrab/src/pinkrab_description/meshes/driver_mount_left.stl

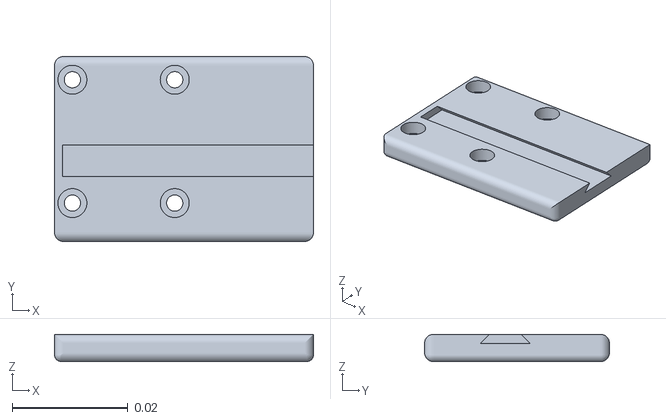
[picture p71: CAD file, 2026-11-01]
src/pinkrab_description/meshes/driver_mount_left.stl
0.0447 x 0.0319 x 0.00468
