woolimi/pinkrab/src/pinkrab_description/mjcf/collision/camera_bracket_right_c08.stl

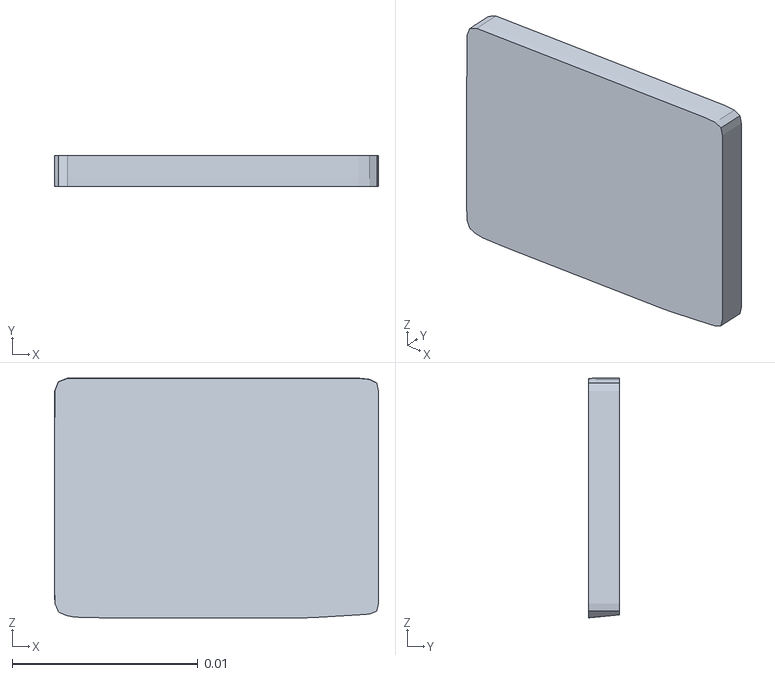
[picture p72: CAD file, 2026-11-01]
src/pinkrab_description/mjcf/collision/camera_bracket_right_c08.stl
0.0175 x 0.00167 x 0.0129
