woolimi/pinkrab/src/pinkrab_description/meshes/shoulder_right.stl

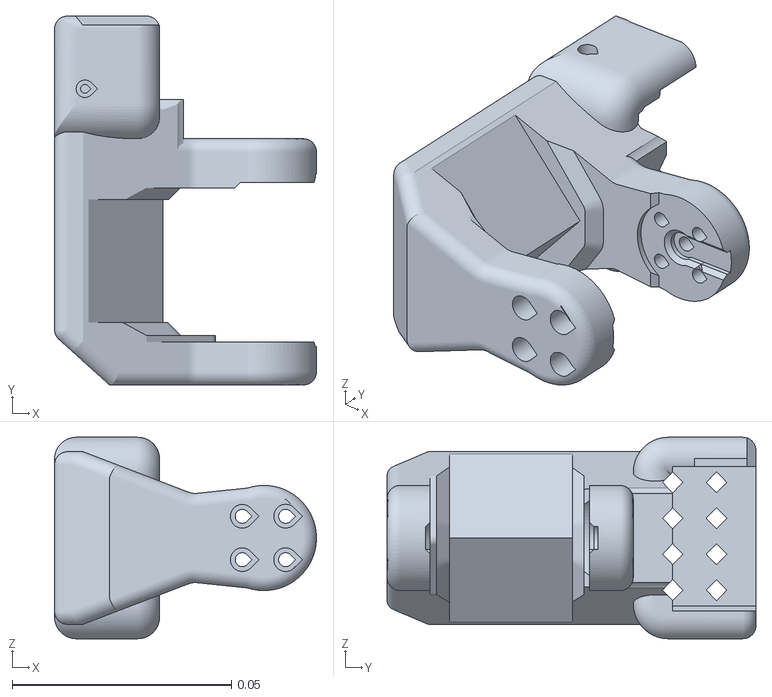
[picture p73: CAD file, 2026-11-01]
src/pinkrab_description/meshes/shoulder_right.stl
0.0598 x 0.0842 x 0.046
