woolimi/pinkrab/src/pinkrab_description/mjcf/collision/claw_right_c02.stl

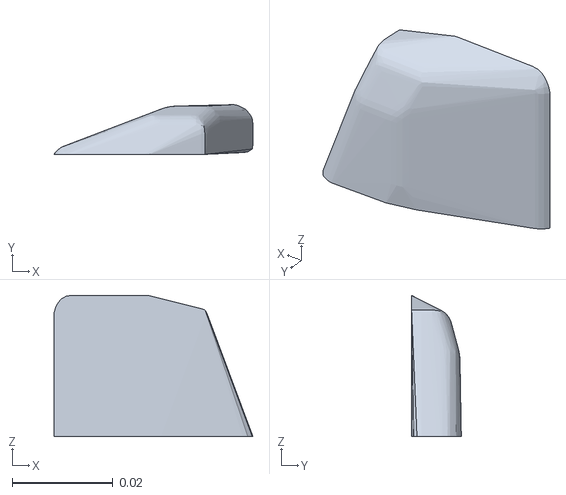
[picture p74: CAD file, 2026-11-01]
src/pinkrab_description/mjcf/collision/claw_right_c02.stl
0.0396 x 0.00988 x 0.0281
