woolimi/pinkrab/src/pinkrab_description/print/pinkrab_arm_right.3mf

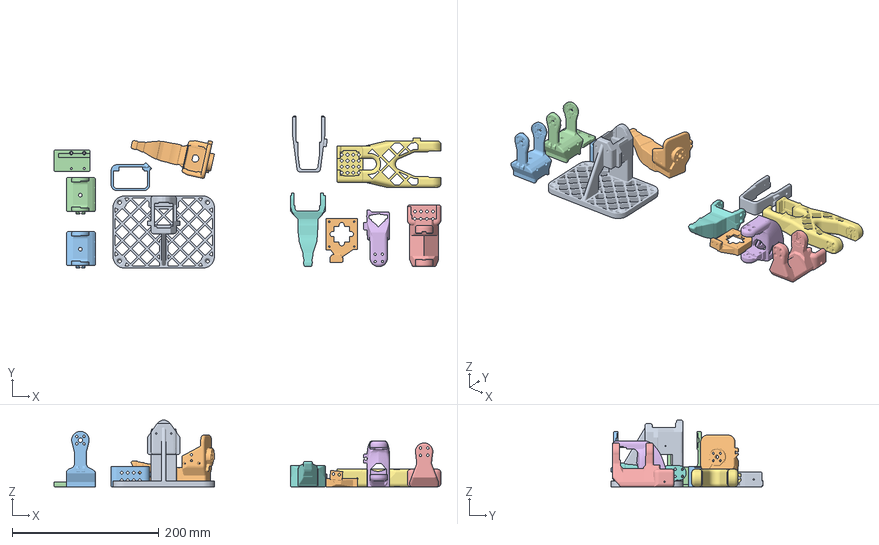
[picture p75: CAD file, 2026-11-01]
src/pinkrab_description/print/pinkrab_arm_right.3mf
528.0 x 207.7 x 90.8 mm
base_right.stl
claw_right.stl
wrist_yaw_bracket_right.stl x 2
shoulder_right.stl
wrist_right.stl
upper_arm_right.stl
jaw_right.stl
base_servo_mount_right.stl
camera_bracket_right.stl
shoulder_servo_mount_right.stl
driver_mount_right.stl
