woolimi/pinkrab/src/pinkrab_description/mjcf/collision/claw_right_c11.stl

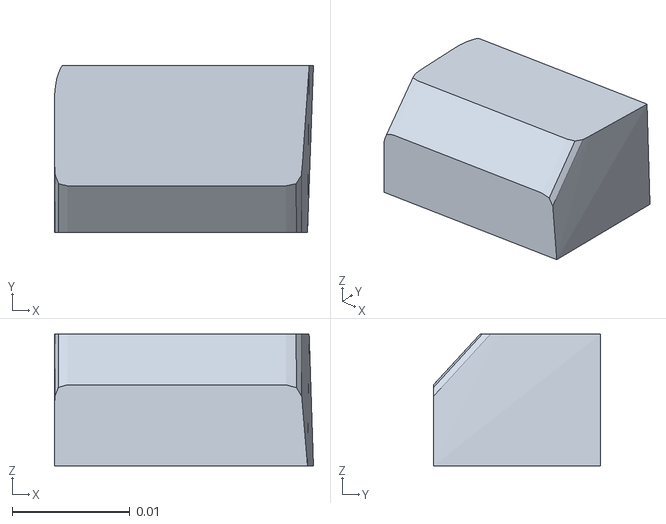
[picture p76: CAD file, 2026-11-01]
src/pinkrab_description/mjcf/collision/claw_right_c11.stl
0.022 x 0.0142 x 0.0112
