woolimi/pinkrab/src/pinkrab_description/mjcf/collision/jaw_left_c05.stl

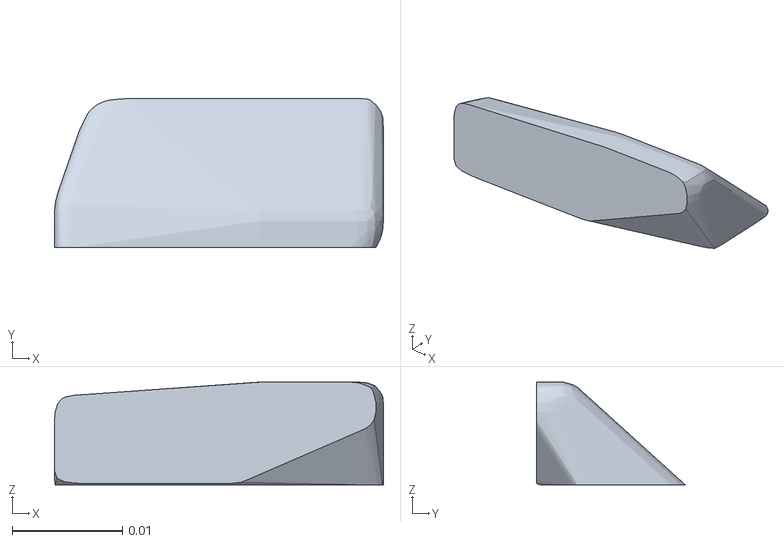
[picture p77: CAD file, 2026-11-01]
src/pinkrab_description/mjcf/collision/jaw_left_c05.stl
0.0299 x 0.0135 x 0.00935
