woolimi/pinkrab/src/pinkrab_description/print/pinkrab_arm_left.3mf

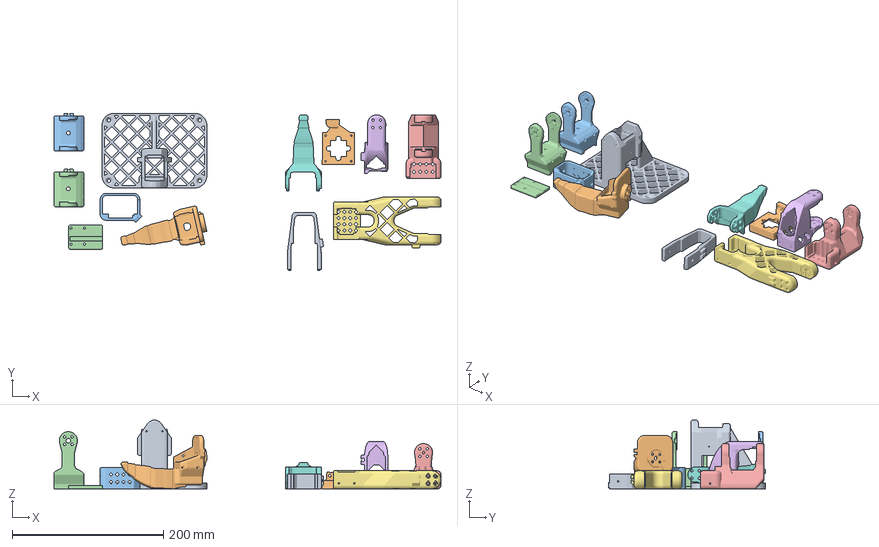
[picture p78: CAD file, 2026-11-01]
src/pinkrab_description/print/pinkrab_arm_left.3mf
510.9 x 207.7 x 90.8 mm
base_left.stl
claw_left.stl
wrist_yaw_bracket_left.stl x 2
shoulder_left.stl
wrist_left.stl
upper_arm_left.stl
jaw_left.stl
base_servo_mount_left.stl
camera_bracket_left.stl
shoulder_servo_mount_left.stl
driver_mount_left.stl
