woolimi/pinkrab/src/pinkrab_description/mjcf/collision/camera_bracket_right_c17.stl

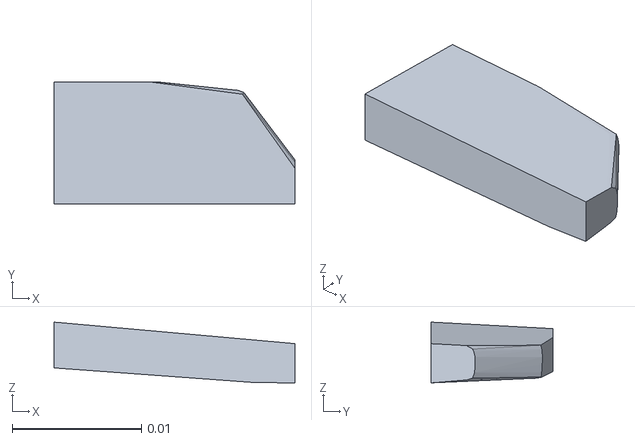
[picture p79: CAD file, 2026-11-01]
src/pinkrab_description/mjcf/collision/camera_bracket_right_c17.stl
0.0187 x 0.00947 x 0.00471
