woolimi/pinkrab/src/pinkrab_description/print/upper_arm_right.stl

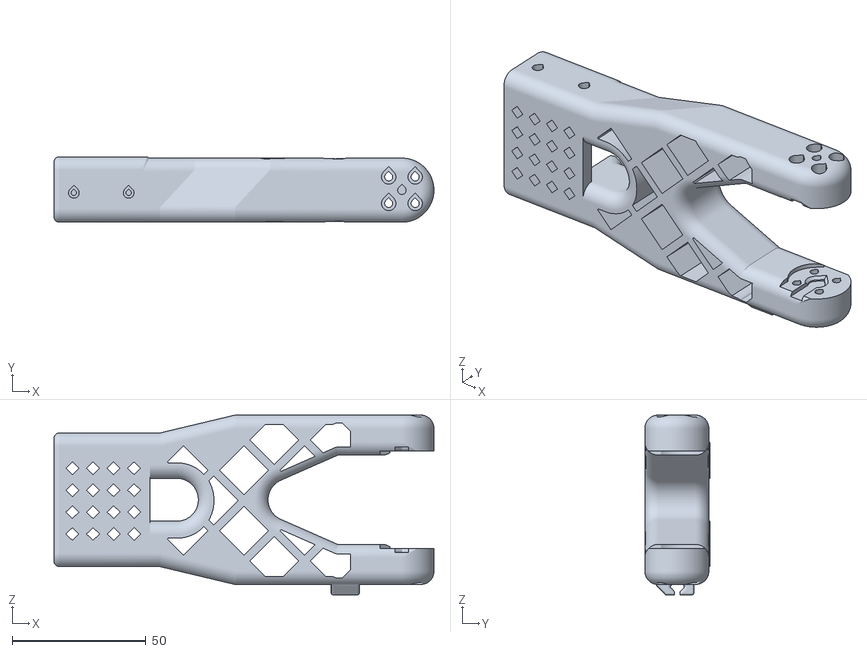
[picture p80: CAD file, 2026-11-01]
src/pinkrab_description/print/upper_arm_right.stl
142.2 x 24.5 x 67.3
