woolimi/pinkrab/src/pinkrab_description/mjcf/collision/camera_bracket_left_c09.stl

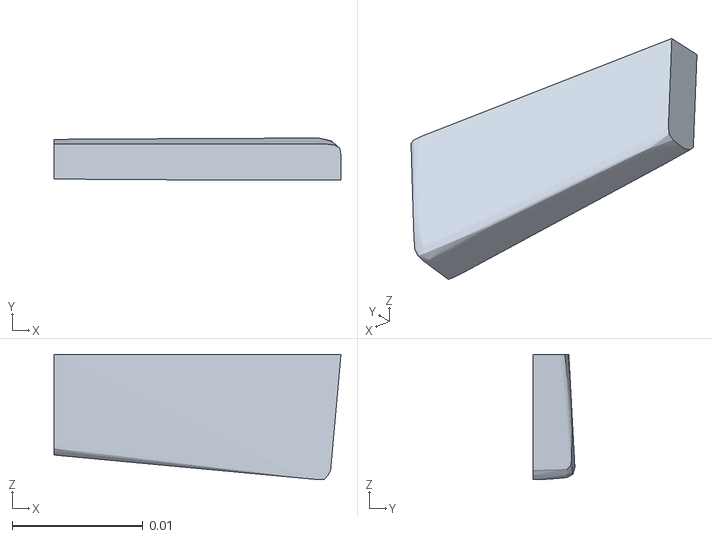
[picture p81: CAD file, 2026-11-01]
src/pinkrab_description/mjcf/collision/camera_bracket_left_c09.stl
0.0219 x 0.0032 x 0.00957
