woolimi/pinkrab/src/pinkrab_description/mjcf/collision/claw_left_c02.stl

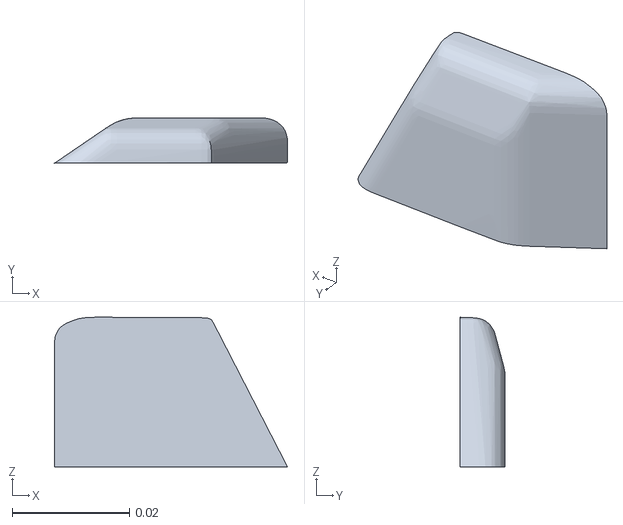
[picture p82: CAD file, 2026-11-01]
src/pinkrab_description/mjcf/collision/claw_left_c02.stl
0.0398 x 0.00775 x 0.0255
