woolimi/pinkrab/src/pinkrab_umi/print/marker_tiles_desk_white.stl

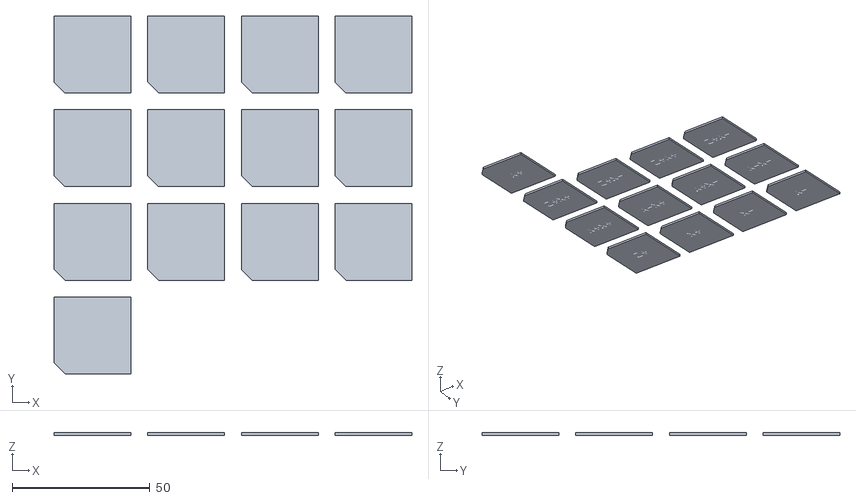
[picture p83: CAD file, 2026-11-01]
src/pinkrab_umi/print/marker_tiles_desk_white.stl
130.0 x 130.0 x 1.00
