woolimi/pinkrab/src/pinkrab_description/mjcf/collision/camera_bracket_right_c02.stl

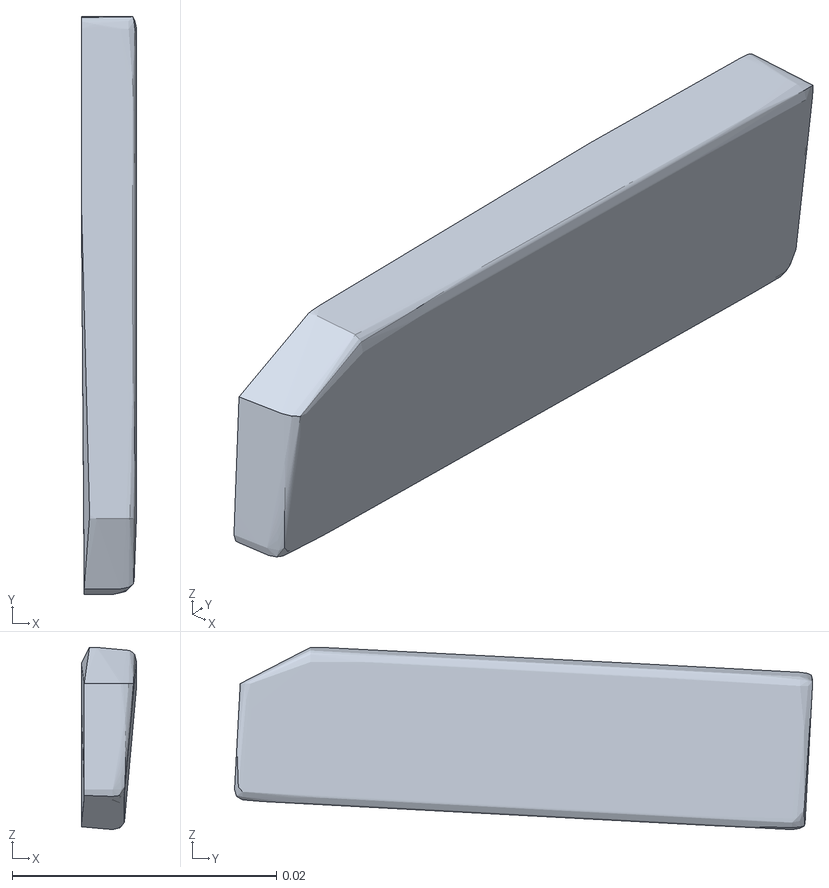
[picture p84: CAD file, 2026-11-01]
src/pinkrab_description/mjcf/collision/camera_bracket_right_c02.stl
0.00419 x 0.0437 x 0.0138
