woolimi/pinkrab/src/pinkrab_description/mjcf/collision/jaw_right_c04.stl

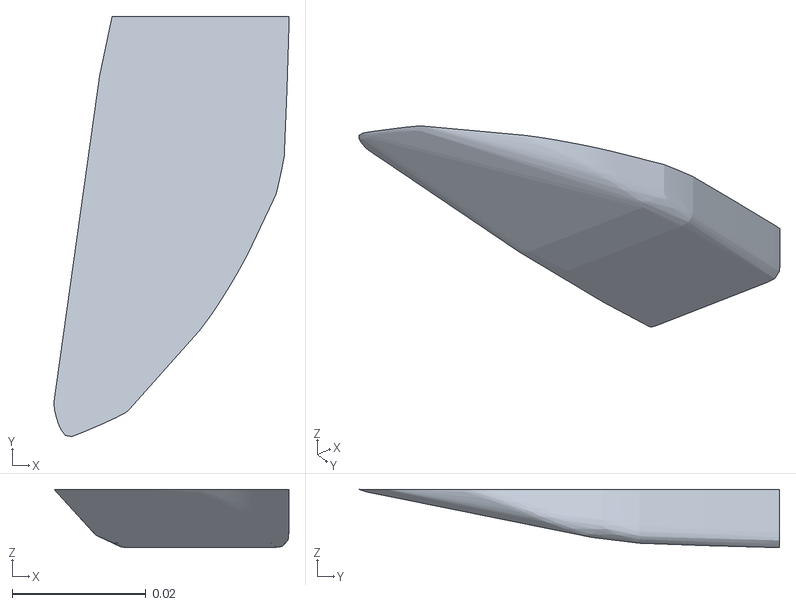
[picture p85: CAD file, 2026-11-01]
src/pinkrab_description/mjcf/collision/jaw_right_c04.stl
0.0351 x 0.0627 x 0.00868
