woolimi/pinkrab/src/pinkrab_description/mjcf/collision/camera_bracket_right_c19.stl

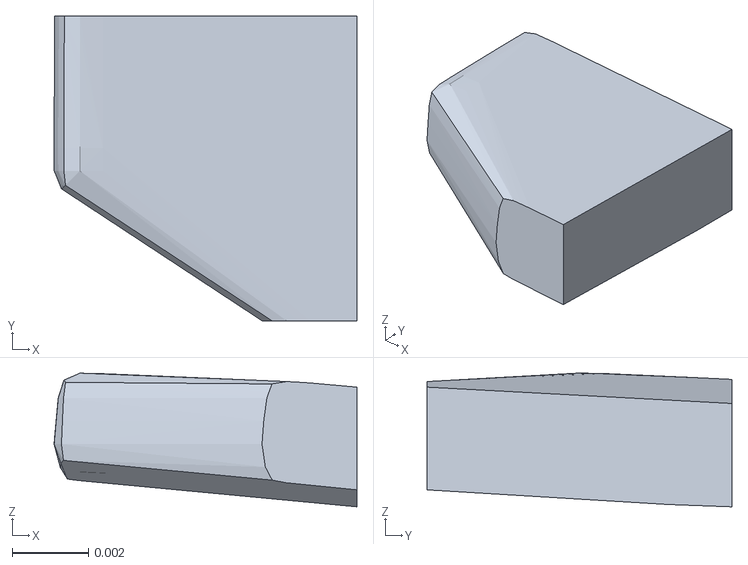
[picture p86: CAD file, 2026-11-01]
src/pinkrab_description/mjcf/collision/camera_bracket_right_c19.stl
0.00796 x 0.008 x 0.00351
