woolimi/pinkrab/src/pinkrab_description/mjcf/collision/jaw_left_c08.stl

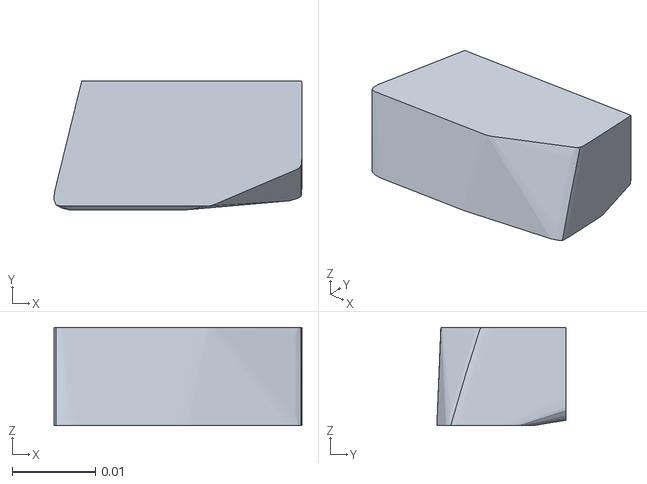
[picture p87: CAD file, 2026-11-01]
src/pinkrab_description/mjcf/collision/jaw_left_c08.stl
0.0298 x 0.0156 x 0.0118
