woolimi/pinkrab/src/pinkrab_umi/print/marker_tiles_handheld_black_right.stl

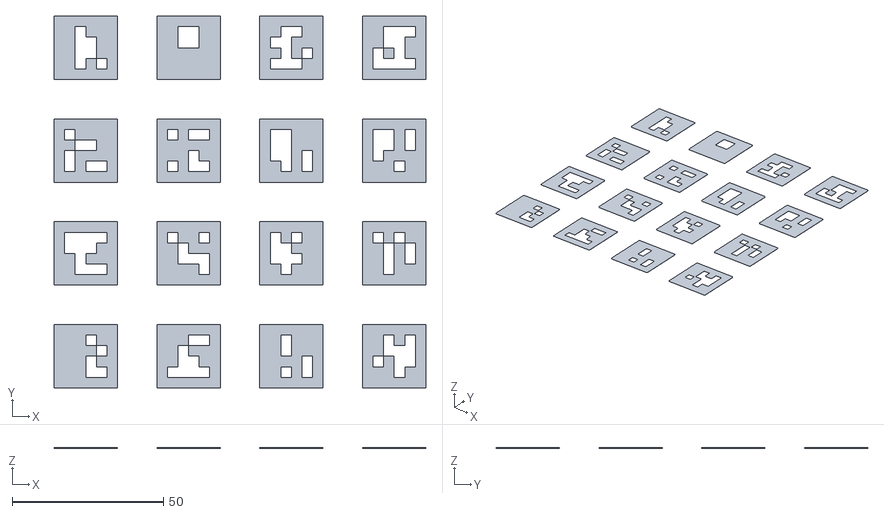
[picture p88: CAD file, 2026-11-01]
src/pinkrab_umi/print/marker_tiles_handheld_black_right.stl
123.0 x 123.0 x 0.4
