woolimi/pinkrab/src/pinkrab_description/mjcf/collision/camera_bracket_right_c11.stl

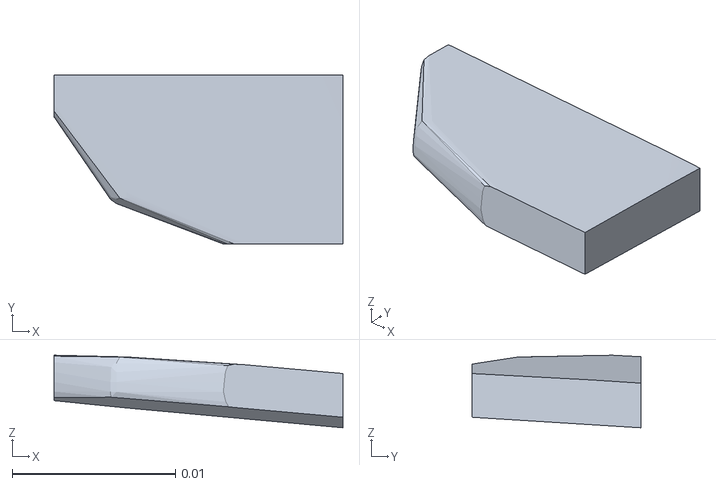
[picture p89: CAD file, 2026-11-01]
src/pinkrab_description/mjcf/collision/camera_bracket_right_c11.stl
0.0177 x 0.0104 x 0.00445
