woolimi/pinkrab/src/pinkrab_umi/print/marker_tiles_desk_black.stl

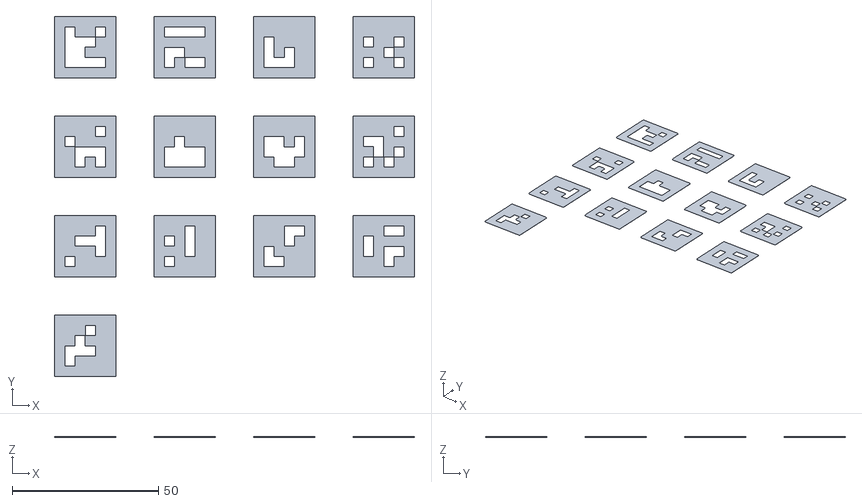
[picture p90: CAD file, 2026-11-01]
src/pinkrab_umi/print/marker_tiles_desk_black.stl
123.0 x 123.0 x 0.4
