woolimi/pinkrab/src/pinkrab_description/mjcf/collision/jaw_right_c06.stl

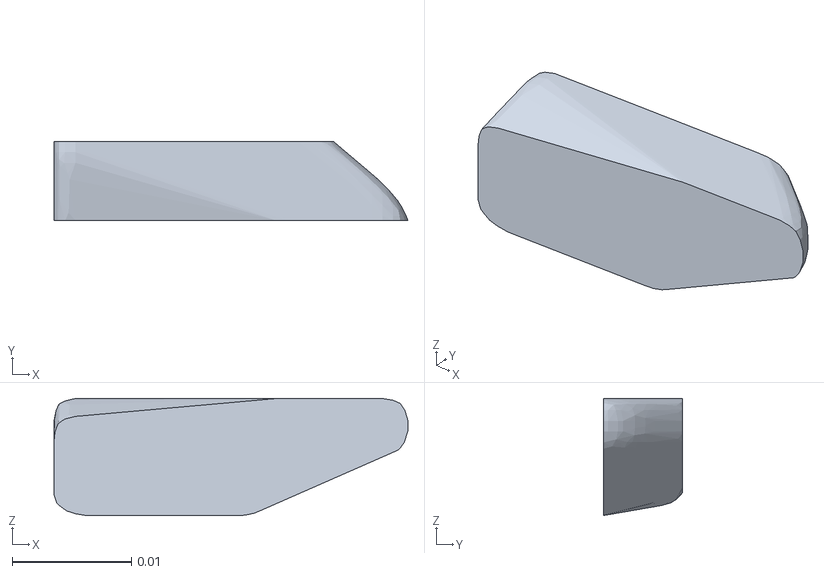
[picture p91: CAD file, 2026-11-01]
src/pinkrab_description/mjcf/collision/jaw_right_c06.stl
0.0297 x 0.00665 x 0.00981
