woolimi/pinkrab/src/pinkrab_description/mjcf/collision/claw_left_c05.stl

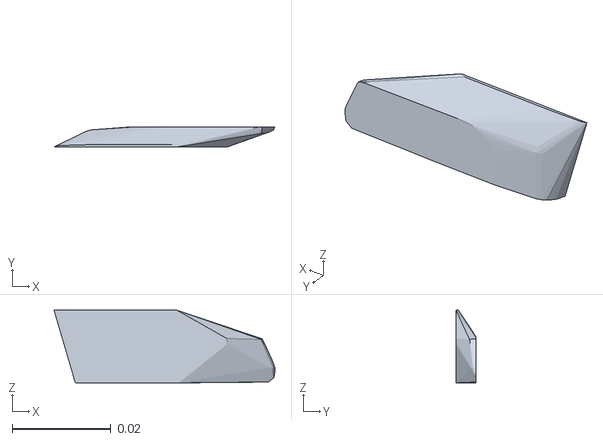
[picture p92: CAD file, 2026-11-01]
src/pinkrab_description/mjcf/collision/claw_left_c05.stl
0.0447 x 0.00405 x 0.0147
