woolimi/pinkrab/src/pinkrab_description/mjcf/collision/jaw_left_c00.stl

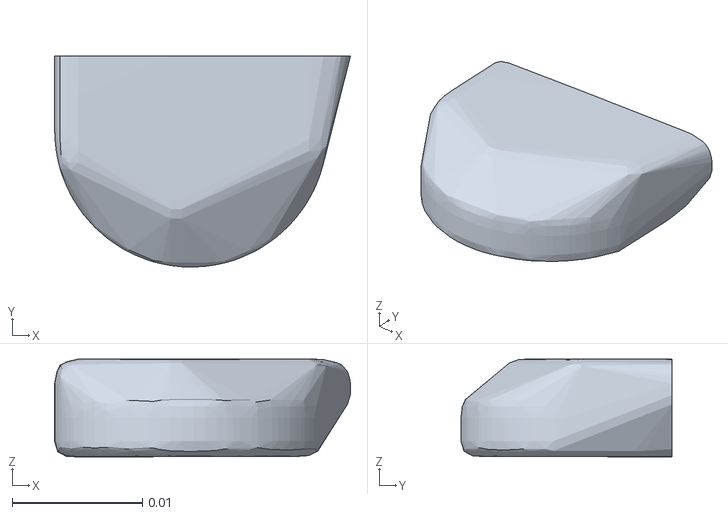
[picture p93: CAD file, 2026-11-01]
src/pinkrab_description/mjcf/collision/jaw_left_c00.stl
0.0227 x 0.0162 x 0.00751
