woolimi/pinkrab/src/pinkrab_description/mjcf/collision/camera_bracket_left_c05.stl

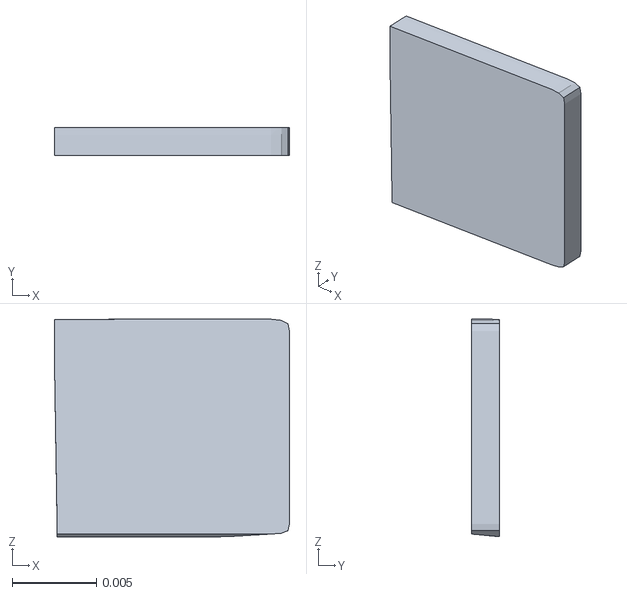
[picture p94: CAD file, 2026-11-01]
src/pinkrab_description/mjcf/collision/camera_bracket_left_c05.stl
0.014 x 0.00166 x 0.0129
