woolimi/pinkrab/src/pinkrab_description/mjcf/collision/jaw_left_c10.stl

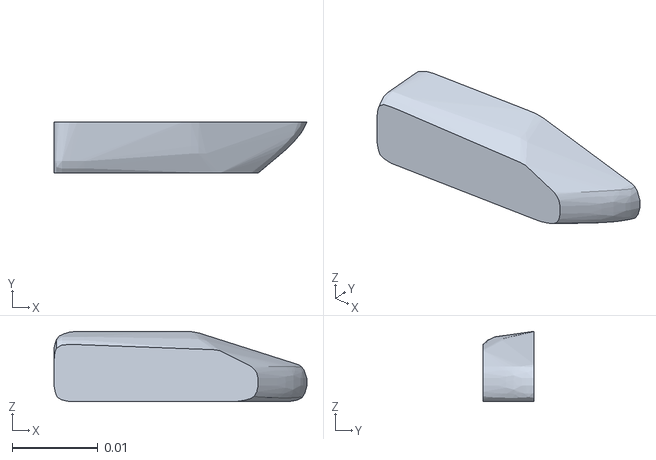
[picture p95: CAD file, 2026-11-01]
src/pinkrab_description/mjcf/collision/jaw_left_c10.stl
0.0296 x 0.00599 x 0.00822
