woolimi/pinkrab/src/pinkrab_description/mjcf/collision/claw_right_c06.stl

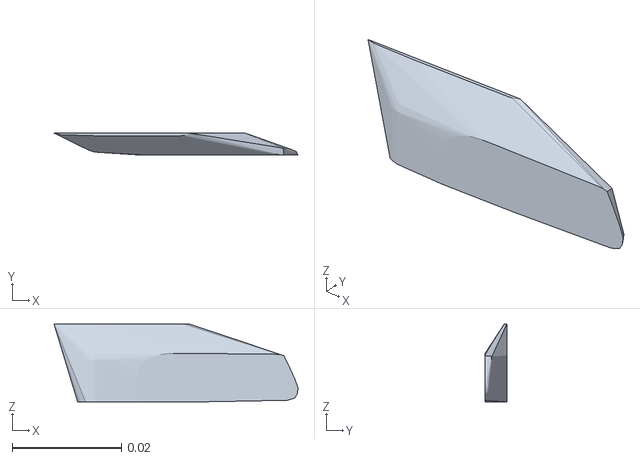
[picture p96: CAD file, 2026-11-01]
src/pinkrab_description/mjcf/collision/claw_right_c06.stl
0.0447 x 0.00398 x 0.0142
