woolimi/pinkrab/src/pinkrab_description/mjcf/collision/camera_bracket_right_c04.stl

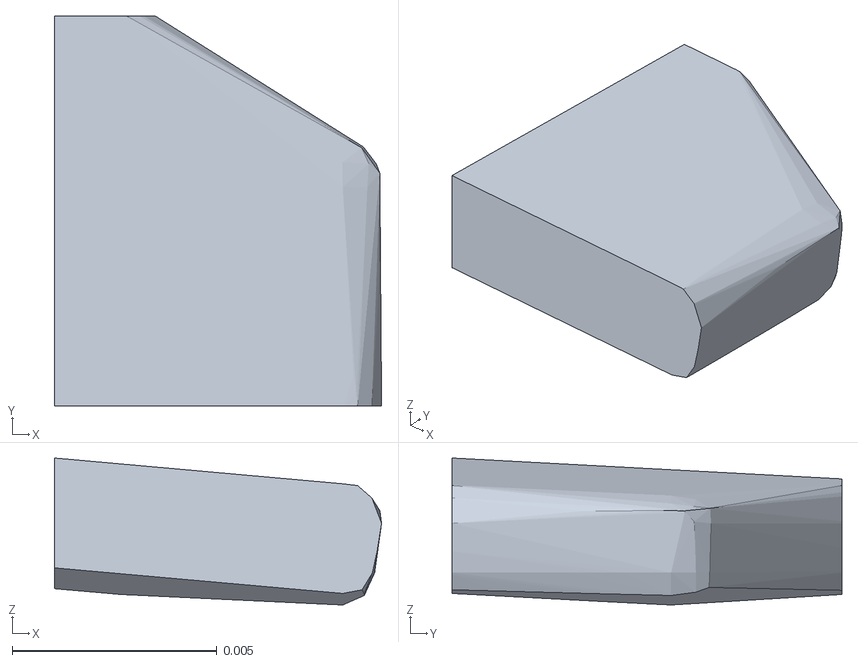
[picture p97: CAD file, 2026-11-01]
src/pinkrab_description/mjcf/collision/camera_bracket_right_c04.stl
0.00799 x 0.00952 x 0.00359
