woolimi/pinkrab/src/pinkrab_description/mjcf/collision/claw_left_c06.stl

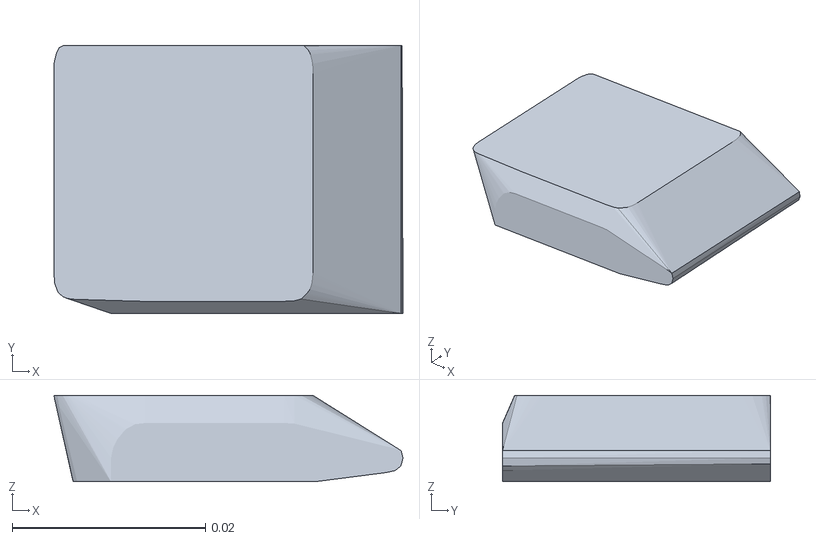
[picture p98: CAD file, 2026-11-01]
src/pinkrab_description/mjcf/collision/claw_left_c06.stl
0.0361 x 0.0277 x 0.00893
