woolimi/pinkrab/src/pinkrab_description/mjcf/collision/camera_bracket_left_c19.stl

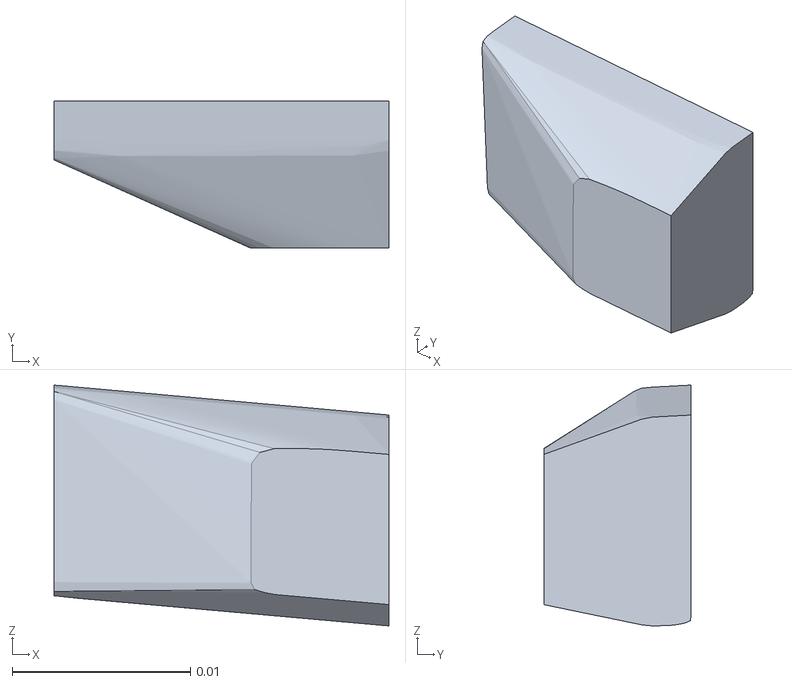
[picture p99: CAD file, 2026-11-01]
src/pinkrab_description/mjcf/collision/camera_bracket_left_c19.stl
0.0188 x 0.00827 x 0.0135
