woolimi/pinkrab/src/pinkrab_description/mjcf/collision/camera_bracket_left_c03.stl

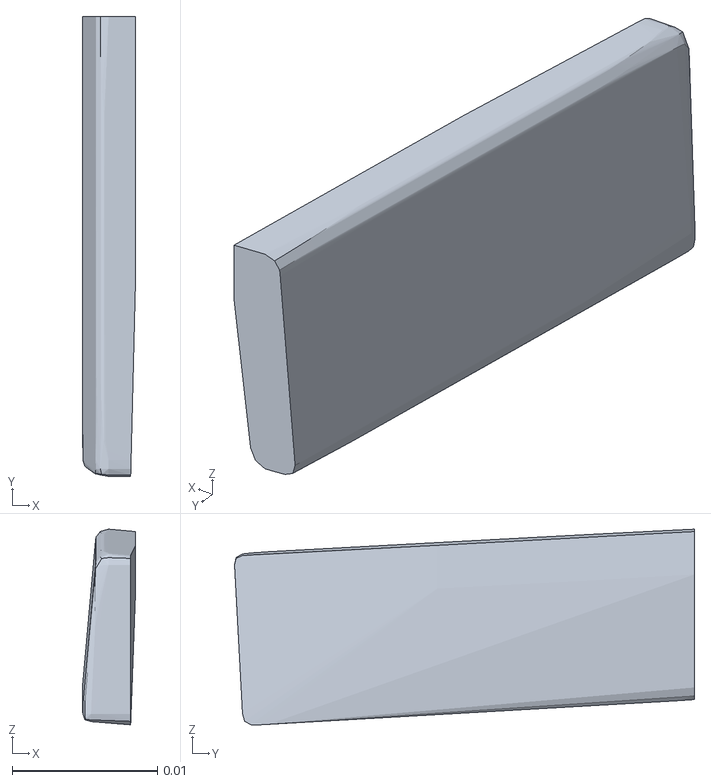
[picture p100: CAD file, 2026-11-01]
src/pinkrab_description/mjcf/collision/camera_bracket_left_c03.stl
0.00367 x 0.0316 x 0.0135
