woolimi/pinkrab/src/pinkrab_description/mjcf/collision/camera_bracket_right_c07.stl

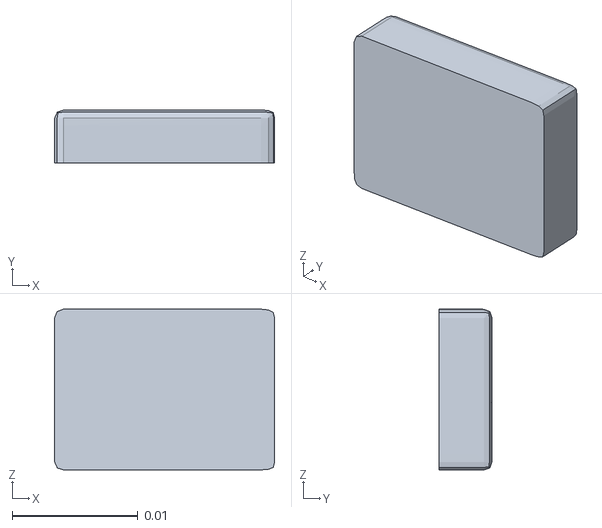
[picture p101: CAD file, 2026-11-01]
src/pinkrab_description/mjcf/collision/camera_bracket_right_c07.stl
0.0175 x 0.00422 x 0.0128
