woolimi/pinkrab/src/pinkrab_description/mjcf/collision/claw_right_c01.stl

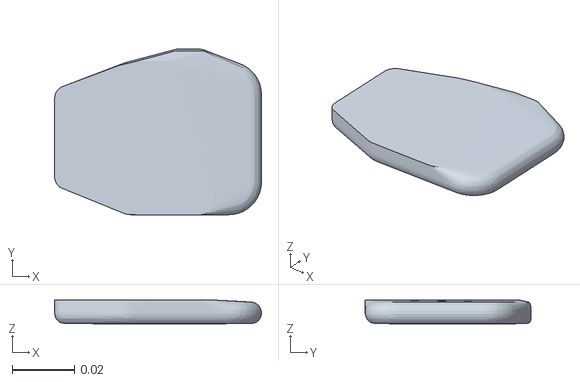
[picture p102: CAD file, 2026-11-01]
src/pinkrab_description/mjcf/collision/claw_right_c01.stl
0.0663 x 0.0531 x 0.00768
