woolimi/pinkrab/src/pinkrab_description/mjcf/collision/jaw_left_c06.stl

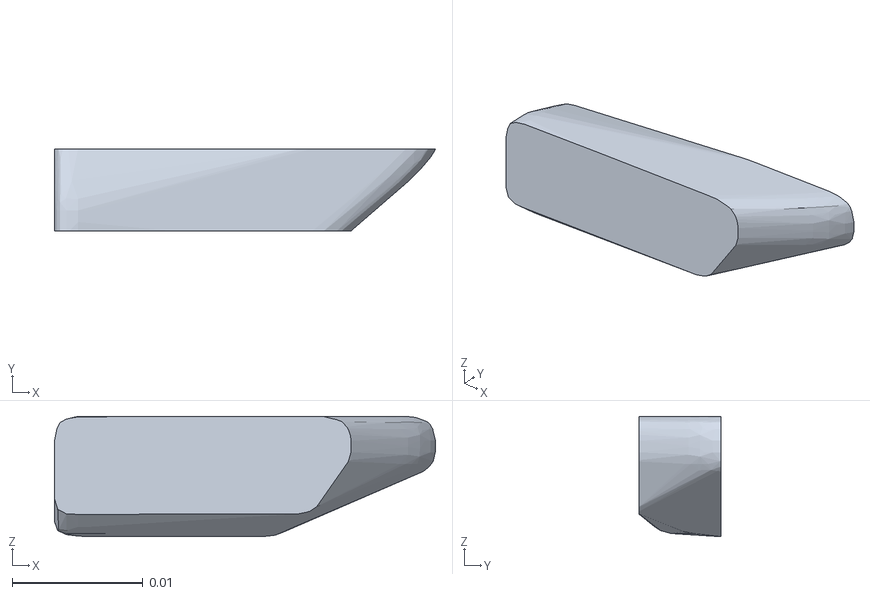
[picture p103: CAD file, 2026-11-01]
src/pinkrab_description/mjcf/collision/jaw_left_c06.stl
0.0292 x 0.00624 x 0.00922
