woolimi/pinkrab/src/pinkrab_description/mjcf/collision/camera_bracket_left_c18.stl

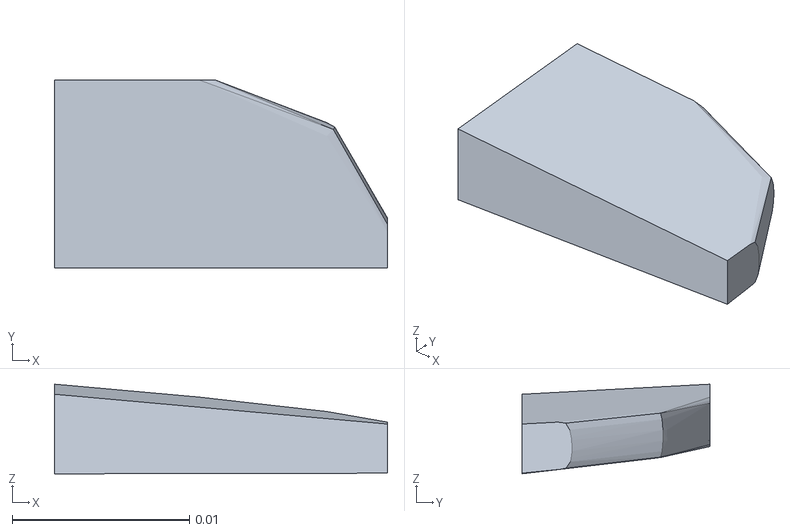
[picture p104: CAD file, 2026-11-01]
src/pinkrab_description/mjcf/collision/camera_bracket_left_c18.stl
0.0188 x 0.0106 x 0.00506
