woolimi/pinkrab/src/pinkrab_description/mjcf/collision/jaw_left_c02.stl

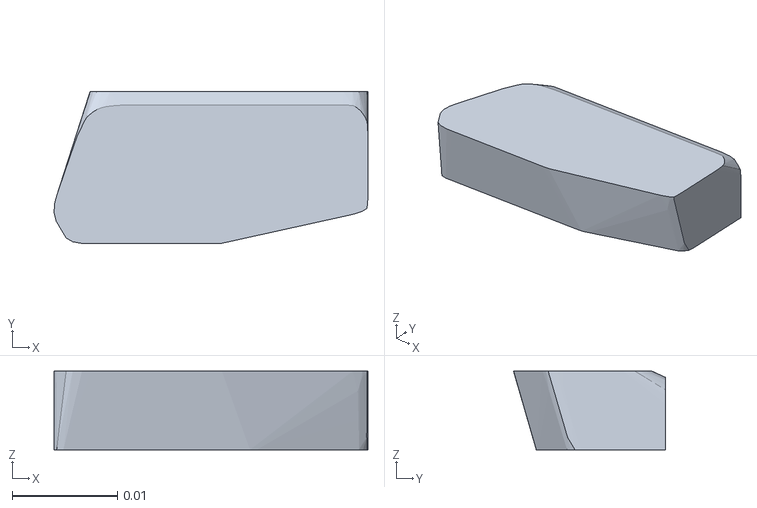
[picture p105: CAD file, 2026-11-01]
src/pinkrab_description/mjcf/collision/jaw_left_c02.stl
0.0298 x 0.0144 x 0.00747
