woolimi/pinkrab/src/pinkrab_description/mjcf/collision/claw_left_c08.stl

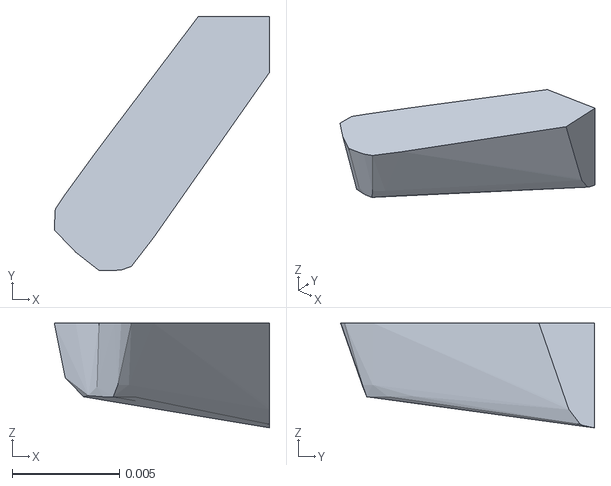
[picture p106: CAD file, 2026-11-01]
src/pinkrab_description/mjcf/collision/claw_left_c08.stl
0.01 x 0.0118 x 0.00488
