woolimi/pinkrab/src/pinkrab_description/mjcf/collision/claw_right_c12.stl

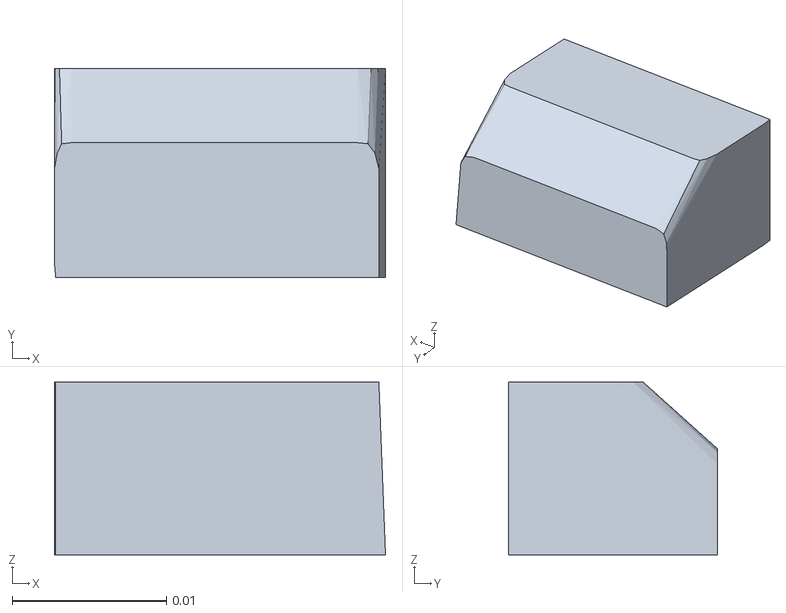
[picture p107: CAD file, 2026-11-01]
src/pinkrab_description/mjcf/collision/claw_right_c12.stl
0.0215 x 0.0135 x 0.0112
