woolimi/pinkrab/src/pinkrab_description/mjcf/collision/camera_bracket_left_c06.stl

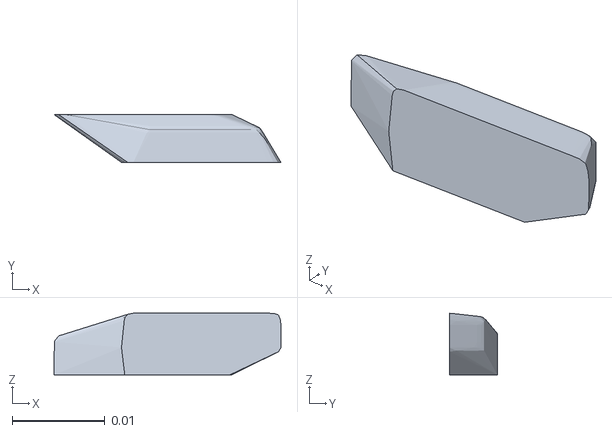
[picture p108: CAD file, 2026-11-01]
src/pinkrab_description/mjcf/collision/camera_bracket_left_c06.stl
0.0244 x 0.00515 x 0.00663
