woolimi/pinkrab/src/pinkrab_description/mjcf/collision/camera_bracket_left_c16.stl

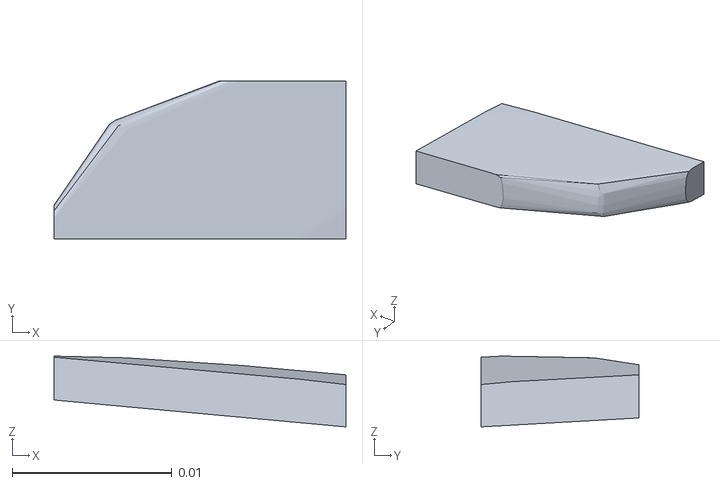
[picture p109: CAD file, 2026-11-01]
src/pinkrab_description/mjcf/collision/camera_bracket_left_c16.stl
0.0183 x 0.00993 x 0.00444
