woolimi/pinkrab/src/pinkrab_description/mjcf/collision/camera_bracket_left_c02.stl

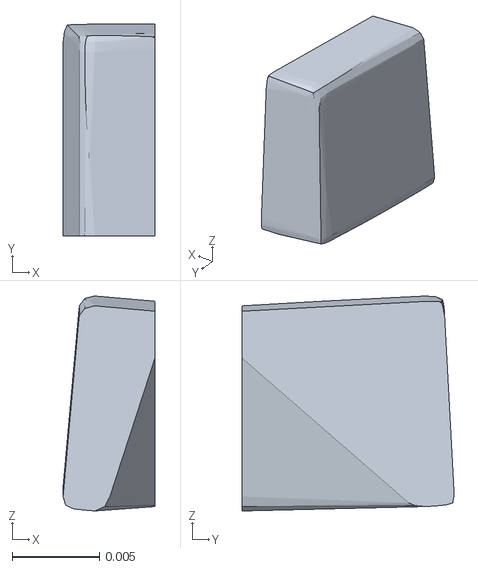
[picture p110: CAD file, 2026-11-01]
src/pinkrab_description/mjcf/collision/camera_bracket_left_c02.stl
0.00525 x 0.0121 x 0.0123
