woolimi/pinkrab/src/pinkrab_description/mjcf/collision/jaw_left_c03.stl

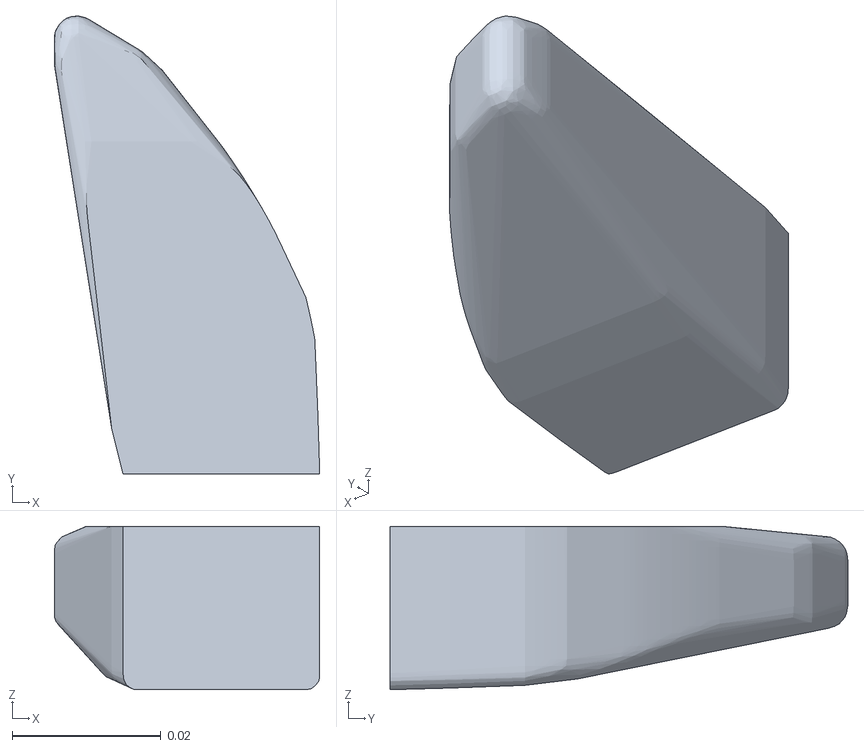
[picture p111: CAD file, 2026-11-01]
src/pinkrab_description/mjcf/collision/jaw_left_c03.stl
0.0357 x 0.0616 x 0.022
