woolimi/pinkrab/src/pinkrab_description/mjcf/collision/jaw_left_c09.stl

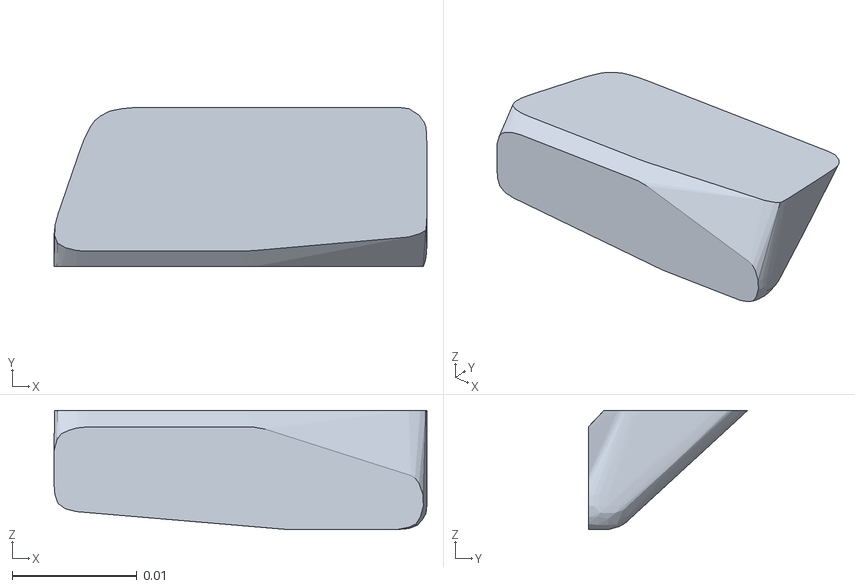
[picture p112: CAD file, 2026-11-01]
src/pinkrab_description/mjcf/collision/jaw_left_c09.stl
0.0299 x 0.0128 x 0.00953
