woolimi/pinkrab/src/pinkrab_description/mjcf/collision/camera_bracket_right_c16.stl

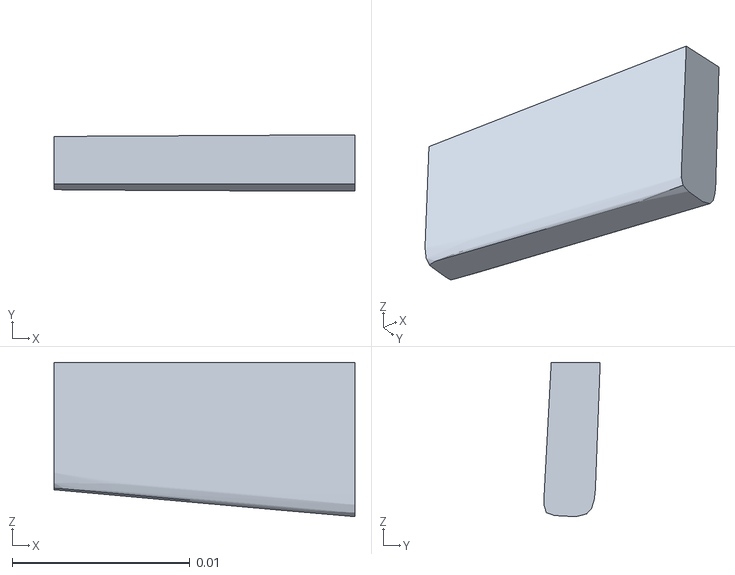
[picture p113: CAD file, 2026-11-01]
src/pinkrab_description/mjcf/collision/camera_bracket_right_c16.stl
0.017 x 0.00318 x 0.00869
