woolimi/pinkrab/src/pinkrab_description/mjcf/collision/claw_right_c09.stl

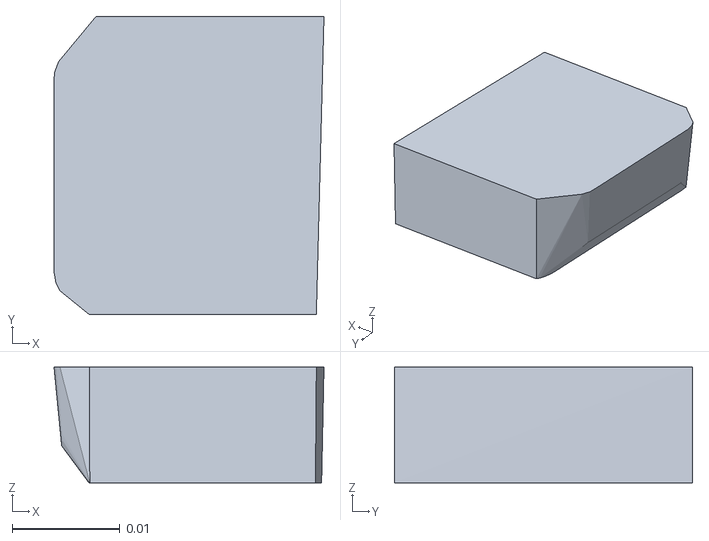
[picture p114: CAD file, 2026-11-01]
src/pinkrab_description/mjcf/collision/claw_right_c09.stl
0.0251 x 0.0277 x 0.0108
