woolimi/pinkrab/src/pinkrab_description/mjcf/collision/jaw_left_c01.stl

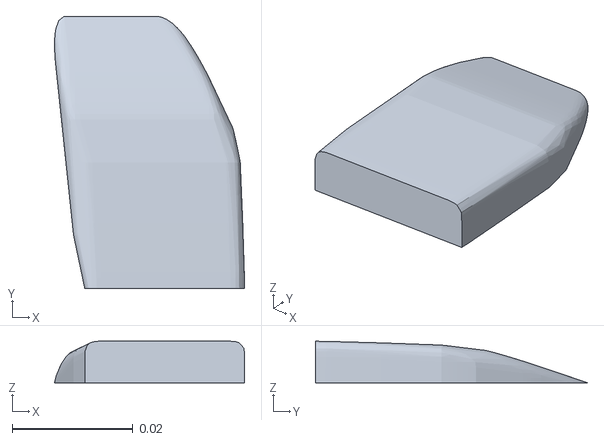
[picture p115: CAD file, 2026-11-01]
src/pinkrab_description/mjcf/collision/jaw_left_c01.stl
0.0314 x 0.0451 x 0.00688
