woolimi/pinkrab/(list of files, cad)

Other CAD files:
src/pinkrab_description/meshes/wrist_right.stl
src/pinkrab_description/print/camera_bracket_left.stl
src/pinkrab_description/print/camera_bracket_right.stl
src/pinkrab_umi/print/umi_desk.3mf
src/pinkrab_description/meshes/camera_bracket_right.stl
src/pinkrab_description/print/shoulder_left.stl
src/pinkrab_description/meshes/upper_arm_left.stl
src/pinkrab_umi/meshes/driver_plate_right.stl
src/pinkrab_description/meshes/camera_bracket_left.stl
src/pinkrab_description/print/base_servo_mount_right.stl
src/pinkrab_umi/meshes/camera_bracket_left.stl
src/pinkrab_umi/meshes/board_mount_left.stl
src/pinkrab_description/print/base_left.stl
src/pinkrab_umi/meshes/handheld_body_left.stl
src/pinkrab_umi/meshes/handheld_jaw_left.stl
src/pinkrab_umi/print/handheld_peg_right.stl
src/pinkrab_description/meshes/claw_right.stl
src/pinkrab_umi/meshes/handheld_peg_left.stl
src/pinkrab_umi/meshes/marker_solid_handheld_right.stl
src/pinkrab_description/print/wrist_right.stl
src/pinkrab_description/meshes/wrist_yaw_bracket_right.stl
src/pinkrab_description/print/claw_right.stl
src/pinkrab_description/print/wrist_yaw_bracket_right.stl
src/pinkrab_umi/print/driver_plate_right.stl
src/pinkrab_umi/print/umi_handheld_parts_right.3mf
src/pinkrab_description/meshes/shoulder_left.stl
src/pinkrab_description/print/shoulder_servo_mount_left.stl
src/pinkrab_umi/print/handheld_jaw_left.stl
src/pinkrab_description/meshes/base_servo_mount_left.stl
src/pinkrab_umi/print/marker_solid_handheld_right.stl
src/pinkrab_description/meshes/base_left.stl
src/pinkrab_description/meshes/shoulder_servo_mount_right.stl
src/pinkrab_description/print/upper_arm_left.stl
src/pinkrab_umi/print/handheld_body_left.stl
src/pinkrab_description/meshes/jaw_left.stl
src/pinkrab_description/print/jaw_right.stl
src/pinkrab_umi/print/marker_solid_tiles_handheld_right.stl
src/pinkrab_umi/print/camera_bracket_right.stl
src/pinkrab_umi/print/board_mount_left.stl
src/pinkrab_umi/print/marker_tiles_handheld_black_left.stl
src/pinkrab_description/mjcf/collision/camera_bracket_left_c11.stl
src/pinkrab_description/mjcf/collision/claw_left_c12.stl
src/pinkrab_description/mjcf/collision/camera_bracket_right_c12.stl
src/pinkrab_description/mjcf/collision/claw_left_c03.stl
src/pinkrab_description/mjcf/collision/camera_bracket_left_c00.stl
src/pinkrab_description/mjcf/collision/camera_bracket_left_c01.stl
src/pinkrab_description/mjcf/collision/camera_bracket_left_c04.stl
src/pinkrab_description/mjcf/collision/camera_bracket_left_c12.stl
src/pinkrab_description/mjcf/collision/camera_bracket_left_c15.stl
src/pinkrab_description/mjcf/collision/camera_bracket_left_c20.stl
src/pinkrab_description/mjcf/collision/camera_bracket_right_c01.stl
src/pinkrab_description/mjcf/collision/camera_bracket_right_c03.stl
src/pinkrab_description/mjcf/collision/camera_bracket_right_c06.stl
src/pinkrab_description/mjcf/collision/camera_bracket_right_c09.stl
src/pinkrab_description/mjcf/collision/camera_bracket_right_c10.stl
src/pinkrab_description/mjcf/collision/camera_bracket_right_c13.stl
src/pinkrab_description/mjcf/collision/camera_bracket_right_c14.stl
src/pinkrab_description/mjcf/collision/camera_bracket_right_c15.stl
src/pinkrab_description/mjcf/collision/claw_left_c00.stl
src/pinkrab_description/mjcf/collision/claw_left_c01.stl
src/pinkrab_description/mjcf/collision/claw_left_c07.stl
src/pinkrab_description/mjcf/collision/claw_left_c09.stl
src/pinkrab_description/mjcf/collision/claw_left_c10.stl
src/pinkrab_description/mjcf/collision/claw_left_c11.stl
src/pinkrab_description/mjcf/collision/claw_right_c03.stl
src/pinkrab_description/mjcf/collision/claw_right_c04.stl
src/pinkrab_description/mjcf/collision/claw_right_c05.stl
src/pinkrab_description/mjcf/collision/claw_right_c07.stl
src/pinkrab_description/mjcf/collision/claw_right_c10.stl
src/pinkrab_description/mjcf/collision/jaw_left_c07.stl
src/pinkrab_description/mjcf/collision/jaw_right_c00.stl
src/pinkrab_description/mjcf/collision/jaw_right_c03.stl
src/pinkrab_description/mjcf/collision/jaw_right_c07.stl
src/pinkrab_description/mjcf/collision/jaw_right_c08.stl
src/pinkrab_description/mjcf/collision/jaw_right_c09.stl
