woolimi/pinkrab/src/pinkrab_umi/print/lens_charuco_a4.pdf

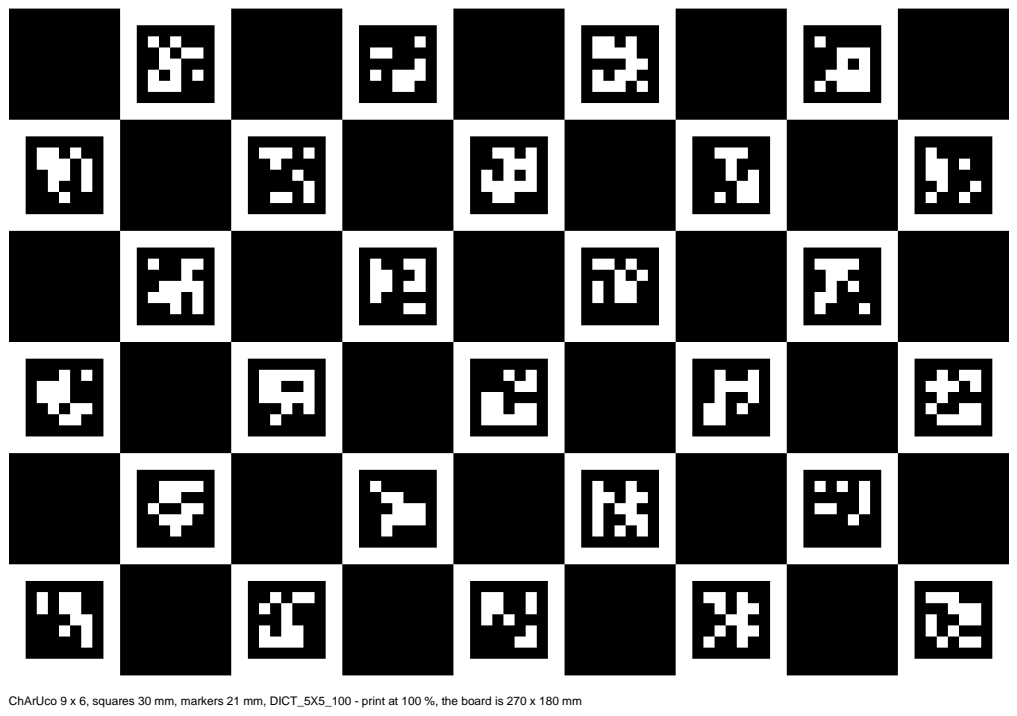
[picture p116: page 1]

ChArUco 9 x 6, squares 30 mm, markers 21 mm, DICT_5X5_100 - print at 100 %, the board is 270 x 180 mm
