woolimi/pinkrab/src/pinkrab_umi/print/marker_solid_desk_sheet.pdf

## Pinkrab UMI marker desk_dome - desk - ids 32-44

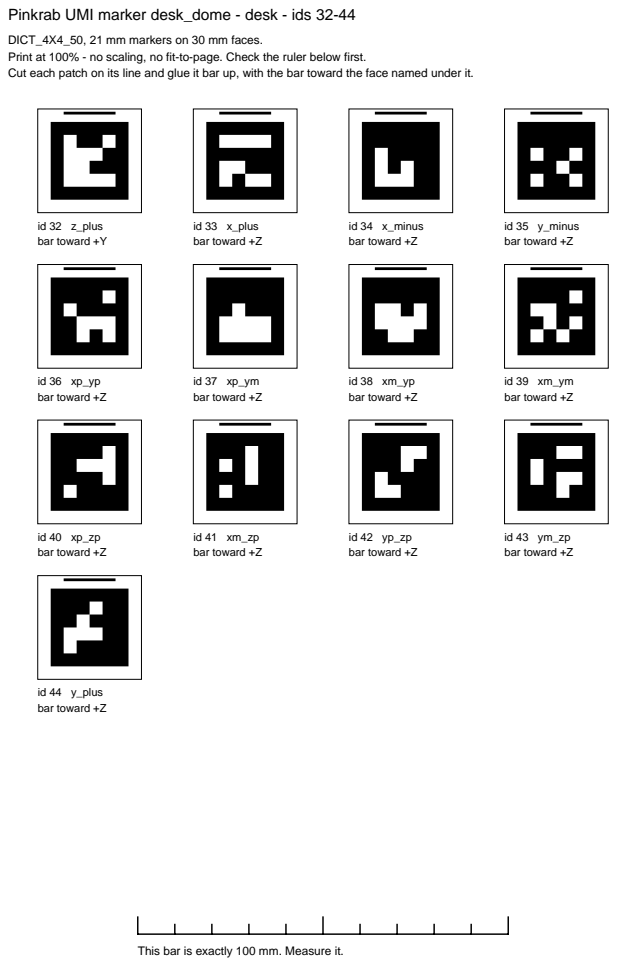
[picture p117: page 1]
id 32 z_plus bar toward +Y; id 33 x_plus bar toward +Z; id 34 x_minus bar toward +Z; id 35 y_minus bar toward +Z; id 36 xp_yp bar toward +Z; id 37 xp_ym bar toward +Z; id 38 xm_yp bar toward +Z; id 39 xm_ym bar toward +Z; id 40 xp_zp bar toward +Z; id 41 xm_zp bar toward +Z; id 42 yp_zp bar toward +Z; id 43 ym_zp bar toward +Z; id 44 y_plus bar toward +Z

DICT_4X4_50, 21 mm markers on 30 mm faces.
Print at 100% - no scaling, no fit-to-page. Check the ruler below first.
Cut each patch on its line and glue it bar up, with the bar toward the face named under it.

This bar is exactly 100 mm. Measure it.
