woolimi/pinkrab/src/pinkrab_umi/print/marker_solid_handheld_left_sheet.pdf

## Pinkrab UMI marker rhombicuboctahedron - handheld_left - ids 0-15

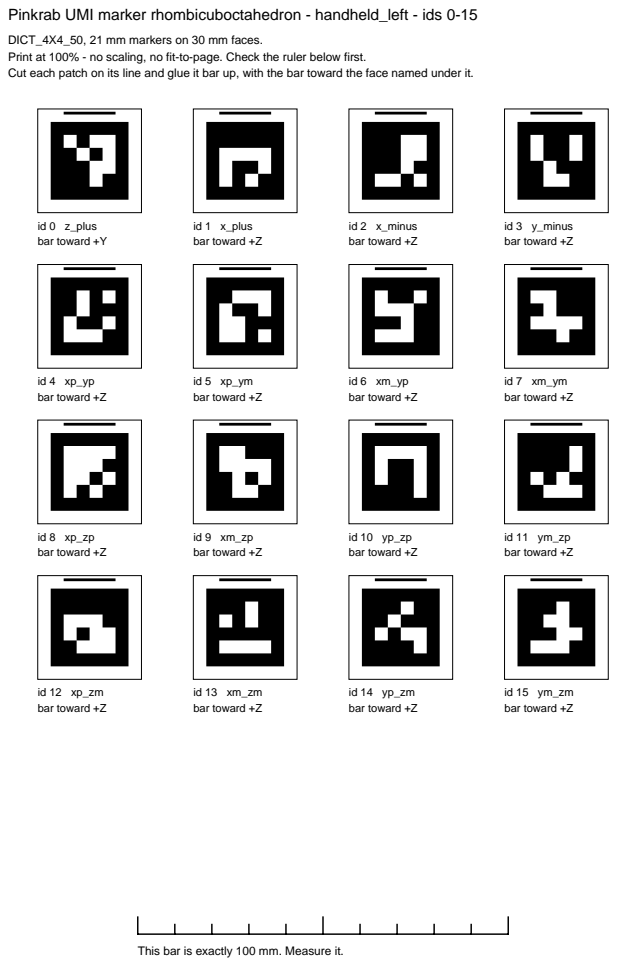
[picture p118: page 1]
id 0 z_plus bar toward +Y; id 1 x_plus bar toward +Z; id 2 x_minus bar toward +Z; id 3 y_minus bar toward +Z; id 4 xp_yp bar toward +Z; id 5 xp_ym bar toward +Z; id 6 xm_yp bar toward +Z; id 7 xm_ym bar toward +Z; id 8 xp_zp bar toward +Z; id 9 xm_zp bar toward +Z; id 10 yp_zp bar toward +Z; id 11 ym_zp bar toward +Z; id 12 xp_zm bar toward +Z; id 13 xm_zm bar toward +Z; id 14 yp_zm bar toward +Z; id 15 ym_zm bar toward +Z

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

This bar is exactly 100 mm. Measure it.
