woolimi/pinkrab/src/pinkrab_umi/print/marker_solid_handheld_right_sheet.pdf

## Pinkrab UMI marker rhombicuboctahedron - handheld_right - ids 16-31

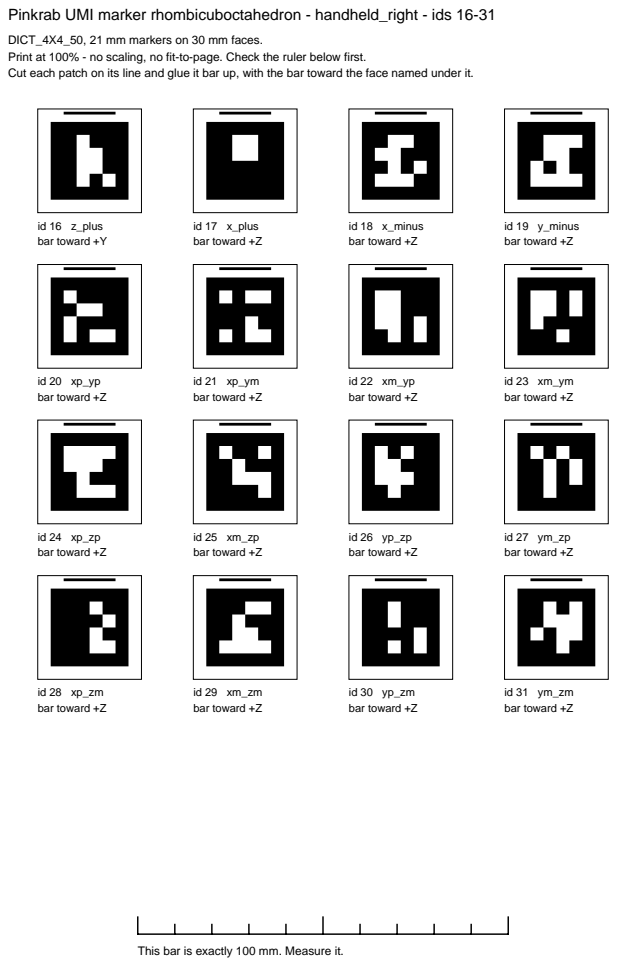
[picture p119: page 1]
id 16 z_plus bar toward +Y; id 17 x_plus bar toward +Z; id 18 x_minus bar toward +Z; id 19 y_minus bar toward +Z; id 20 xp_yp bar toward +Z; id 21 xp_ym bar toward +Z; id 22 xm_yp bar toward +Z; id 23 xm_ym bar toward +Z; id 24 xp_zp bar toward +Z; id 25 xm_zp bar toward +Z; id 26 yp_zp bar toward +Z; id 27 ym_zp bar toward +Z; id 28 xp_zm bar toward +Z; id 29 xm_zm bar toward +Z; id 30 yp_zm bar toward +Z; id 31 ym_zm bar toward +Z

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

This bar is exactly 100 mm. Measure it.
