woolimi/pinkrab/(commit log)

2026-11-01 Pinkrab
    Two 6-DoF arms on a wall board and the Hermit handheld grippers that teach
    them: the printed parts and their print projects, the robot description, the
    ROS 2 driver, safety gate, bridge and teleoperation, the studio, the handheld
    collection and LeRobot conversion, the MuJoCo simulation, and ACT training
    and rollout.
    [base_left.stl, base_right.stl, base_servo_mount_left.stl, base_servo_mount_right.stl, board_mount_left.stl, board_mount_right.stl, camera_bracket_left.stl, camera_bracket_left_c00.stl]
2026-11-01 Fix findings from a full code review
    Safety path: a single gate-owned /estop that retries torque off until the
    driver confirms; stops are redelivered until done; limp arms are not
    commanded and re-anchor on torque change; resting contacts cannot deepen;
    contact checked along the step; per-arm torque off; torque state read at
    start; the walk home stays abortable after Ctrl-C (the driver owns its
    signals so its context stays up); rollout waits for the arm and stops on
    lag; silence timeouts scale with the command rate; teleop ignores a frozen
    picture.
    Studio: reject ssh option injection; Origin, Host and JSON checks on every
    request; no sudoers wildcard; fetch retry backoff; output-independent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
    [arms.py, assign.py, cli.py, config.py, convert.py, demo_start.py]
2026-11-01 Let fingers pressed past where they rested lift out
    Fingers read deeper than the shallowest reading since they touched the desk
    could only move to a pose at or above that reading, so a walk whose first
    ramped step lifted them a little was refused every tick and the arm stayed
    pressed in. A moving hand's fingertips may now come out by any amount, as
    other resting contacts already may; going no deeper than they rest is
    unchanged.
2026-11-01 Add English documentation and a Korean README
    The docs site gains an en locale beside the Korean root: every page under
    en/, English sidebar labels and UI strings, and components and scripts that
    pick their visible text by the page language. Assembly steps carry English
    beside Korean. README.md links the English docs and README.ko.md is the
    Korean front page.
2026-11-01 Point the README at the docs and stage the front page
    The README now leads with a photo of both arms and both Hermits, draws the
    workflow as an SVG in each language, links MakerWorld, and sends readers to
    the documentation instead of carrying install steps and the repository layout.
    Those move to two new pages, Simulation and Repository layout, in Korean and
    English; the printing page links MakerWorld too.
    The front page waits for the robot behind one loading screen, then brings the
    name in letter by letter, the robot, each label with its line drawn out from
    the robot, and the words under the name. The Introduction button is a deep
    pink slab with the claw on a badge. Phones get the labels a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
